MingMingL/little_dog/docs/固件开发环境.md

# 机器狗 V1 固件开发环境说明

> 状态：**首次编译已通过**（2026-10-14），产物 `build/xiaozhi.bin`（2,132,880 字节），板卡 `ai-dog-s3` 已生效；**尚未在真实硬件上验证**（主控仍在途中）。
> 本文所有引脚与命令以 `firmware/xiaozhi-esp32` 工作副本为准。

## 1. 技术选型

语音聊天直接采用开源项目 [xiaozhi-esp32](https://github.com/78/xiaozhi-esp32)（MIT 许可）作为设备端语音栈，不自己实现传输、编解码与打断逻辑。

已确认的关键事实（来自项目 README）：

- 支持 ESP32-S3，通信为 **WebSocket** 或 **MQTT + UDP**，音频为 **Opus**；
- 支持传统 **ASR → LLM → TTS** 级联，也支持 Realtime 端到端语音模型；
- 离线唤醒基于乐鑫 **ESP-SR**，支持自定义唤醒词；具备 AEC 硬件时可全双工；
- 服务端可选官方云 **xiaozhi.me**（本次先用它打通链路），或自建 Python/Java/Go 服务端；
- 构建要求 **ESP-IDF v6.0.1+（推荐 v6.1）**，**不再支持 IDF 5.x**。

## 2. 本机环境

| 项 | 值 |
|---|---|
| IDF 版本 | v6.1 |
| IDF_PATH | `F:\software\EspIdfOnline\.espressif\v6.1\esp-idf` |
| IDF_TOOLS_PATH | `C:\Espressif\tools`（编译器/cmake/ninja/Python 虚拟环境均在此） |
| 环境激活脚本 | `C:\Espressif\tools\Microsoft.v6.1.PowerShell_profile.ps1` |
| Python（IDF） | `C:\Espressif\tools\python\v6.1\venv` |
| Xtensa 工具链 | `xtensa-esp-elf esp-15.2.0_20251204` |

### 两个已踩的坑

1. **不要运行 `install.ps1`**：本机会报 `Start-Process : 已添加项。字典中的关键字:"http_proxy"...`，原因是环境变量里同时存在 `http_proxy` 与 `HTTP_PROXY`（大小写重复键），PowerShell `Start-Process` 会抛异常。工具链本来就已装好，无需再装。
2. **工具链在 `C:\Espressif\tools`，不在 `C:\Users\<你>\.espressif`**。误跑过一次 `idf_tools.py install` 会在 `C:\Users\lmmmm\.espressif` 留下不完整下载（只有 gdb 相关），可安全删除。

## 3. 仓库结构

```
AI-Dog/
├── docs/                       # 文档（PRD 等）
├── firmware/
│   ├── xiaozhi-esp32/          # 工作副本（已 git init，基于上游快照）
│   │   └── main/boards/ai-dog-s3/   # 我们新增的板级配置
│   ├── config/ai-dog-s3.defaults    # 板级选择（Kconfig）
│   └── build-ai-dog.ps1        # 构建/烧录/监视脚本
└── vendor/xiaozhi-esp32/       # 上游只读参考（不要在这改）
```

- `vendor/` 保持上游原样，方便以后 `git pull` 对比升级。
- `firmware/xiaozhi-esp32/` 是真正编译的工程，我们的改动都在这里。

## 4. 板级配置 `ai-dog-s3`

为什么不用现成配置：xiaozhi 对 ESP32-S3 的**默认板级是 `bread-compact-wifi`（面包板精简 WiFi）**，但它假设接了 SSD1306 OLED；我们没有买屏幕，直接编译会在启动时报显示初始化错误。因此新增 `ai-dog-s3`：

- `GetDisplay()` 返回 `NoDisplay()`；
- `GetLed()` 返回 `NoLed`（官方 DevKitC-1 的 GPIO48 是 WS2812，首版先不驱动）；
- 音频引脚沿用官方面包板方案，方便照图接线；
- BOOT 键（GPIO0）：未配网进配网，已配网切换语音对话（对应 PRD **FR-17**）。

### 引脚分配

| 功能 | GPIO | 备注 |
|---|---|---|
| INMP441 WS / SCK / SD | 4 / 5 / 6 | I²S 麦克风输入 |
| MAX98357A DIN / BCLK / LRC | 7 / 15 / 16 | I²S 功放输出 |
| BOOT 按键 | 0 | 配网 / 切换对话 |
| I²C SDA / SCL | 41 / 42 | 给 VL53L0X 测距（屏幕未用） |
| 电池电压采样 | 8 | ADC，需分压后接入 |
| 左电机 PWM / IN1 / IN2 | 11 / 12 / 13 | TB6612，后续阶段启用 |
| 右电机 PWM / IN1 / IN2 | 14 / 21 / 47 | TB6612，后续阶段启用 |
| 电机驱动 STBY | 10 | TB6612 待机控制 |
| 巡线传感器 1–5 | 17 / 18 / 38 / 39 / 40 | TCRT5000 数字输入 |
| 模式切换按键 | 9 | 待机/聊天/巡逻/看门 |

> 已避开 N16R8 的 PSRAM 占用脚（33–37）、Flash 脚（26–32）、USB（19/20）与 strapping 脚（3/45/46）。
> 电机、巡线、看门相关引脚**首版固件尚未初始化**，仅先占位。

## 5. 构建与烧录

```powershell
cd F:\software\workbuddy\AI-Dog\firmware
.\build-ai-dog.ps1                              # 编译
.\build-ai-dog.ps1 -Action flash -Port COM3     # 烧录（按实际串口改）
.\build-ai-dog.ps1 -Action monitor -Port COM3   # 看日志
.\build-ai-dog.ps1 -Action menuconfig           # 改配置
```

脚本里已固化下面 5 项环境修正（**别删**，删了就会复现首次编译时那串报错）：

1. `IDF_COMPONENT_CACHE_PATH` → 工作区：组件管理器默认往 `%LOCALAPPDATA%\Espressif\ComponentManager\Cache` 解压，会被拒写。变量名必须是 `IDF_COMPONENT_CACHE_PATH`（前缀 + `CACHE_PATH` 字段），写成 `IDF_COMPONENT_CACHE` 会静默失效。
2. `CODEBUDDY_SAFE_DELETE_ENABLED=0`：cmake 配置阶段会批量删临时文件，超过 50 个文件即被保护机制 fail-closed 拦截，configure 直接失败。
3. `TMP/TEMP` → `firmware/.build-tmp`：`gcc`/`as` 的临时文件默认在系统 Temp，编译到一半会被拒。
4. `CCACHE_DISABLE=1`：ccache 的临时目录同样会被拒；首次编译本来也用不上缓存。
5. 重配置时加 `-DCMAKE_NINJA_FORCE_RESPONSE_FILE=1`：链接 `xiaozhi.elf` 前的编译命令有上百个 `-I`，会撞 Windows 命令行 32767 字符上限报 `CreateProcess: The parameter is incorrect`。CMake 打印的 "变量未被使用" 是误报，`build.ninja` 里确实生成了 `RSP_FILE`。

其它经验：构建需在**非沙箱模式**下跑（沙箱会在编译到第 1000 个目标左右开始拒绝 .obj 写入）；失败后续跑 `ninja -C build all` 是增量的，不要删 `build/` 重来；`.ps1` 脚本保持 ASCII（PowerShell 5.1 按 GBK 读无 BOM 文件，中文注释会破坏解析）。

### 首次编译产物

| 文件 | 大小 | 说明 |
|---|---|---|
| `build/xiaozhi.bin` | 2,132,880 B（约 2.0 MB） | 主程序，16 MB flash 余量充足 |
| `build/bootloader/bootloader.bin` | 16,736 B | 二级 bootloader |
| `build/partition_table/partition-table.bin` | 3,072 B | 分区表 |
| `build/ota_data_initial.bin` | 8,192 B | OTA 初始数据 |

`sdkconfig` 中已生效：`CONFIG_BOARD_TYPE_AI_DOG_S3=y`、`CONFIG_IDF_TARGET="esp32s3"`。

烧录完成后，按官方流程配网（热点或 BluFi），设备默认连接 xiaozhi.me；登录控制台即可配置大模型与音色。

## 6. 与 PRD 的对应

| PRD 条目 | 现状 |
|---|---|
| FR-17 聊天发起（按键） | 已由 BOOT 键实现（照 xiaozhi 默认行为） |
| FR-18 云端语音链路 | 由 xiaozhi + xiaozhi.me 提供，凭据在服务端 |
| FR-19 半双工回声控制 | 首版沿用 xiaozhi 行为；全双工/AEC 待真机验证后再评估 |
| FR-20 失败处理 | xiaozhi 已有重连/超时处理，需真机验证 |
| FR-21 唤醒词 | 后续可选（ESP-SR），先按键 |
| §8 软件架构 | PRD 原写「ESP-IDF/Arduino-ESP32」，实际采用 ESP-IDF v6.1 + xiaozhi 语音栈，已在 PRD 中同步 |

## 7. 后续接入点（硬件到货后）

1. 在 `ai_dog_s3_board.cc` 里加模式状态机（待机/聊天/巡逻/看门）与互锁（FR-01、FR-09）。
2. 接巡线与 VL53L0X，实现循线行驶与遇障停车（FR-06、FR-07、FR-08）。
3. 用同一路麦克风做看门声检测（能量阈值 + 持续时间 + 冷却），触发本地狗叫（FR-11～FR-14）。
4. 通过 MCP 把「开始巡逻 / 设防」等动作暴露给语音，实现用说话控制机器狗。
5. 再评估是否从 FR-19 的半双工升级到全双工（取决于 AEC 实测效果）。
