MingMingL/little_dog/output/机器狗V1产品需求文档.md

# 机器狗 V1 产品需求文档（PRD）

| 项目 | 内容 |
|---|---|
| 文档版本 | 0.1（评审草案） |
| 日期 | 2026-10-13 |
| 产品形态 | 2WD 轮式移动机器人，外观采用 3D 打印狗形外壳 |
| 目标读者 | 产品、嵌入式/硬件、Android、测试 |
| 当前状态 | 需求范围已初步收敛；硬件型号、云服务与若干阈值待验证 |
| 交付形式 | Markdown |
| 预算口径 | 硬件目标约 ¥500（估算，非报价）；云服务费与已有设备不计入 |

## 修订记录

| 版本 | 日期 | 修订说明 | 修订人 |
|---|---|---|---|
| 0.1 | 2026-10-13 | 首版草稿：确定 2WD 固定路线方案、功能需求、验收标准与预算表 | 待填写 |

## 评审摘要（30 秒结论）

- **做什么：** 2WD 轮式狗形原型，提供固定路线循线巡逻（遇障停车）、本地声音触发狗叫告警、云端语音聊天三类能力。
- **不做什么：** 不做 SLAM/自由地图导航、四足步行、自动回充，也不做门外声源定位或认证级安防。
- **硬件目标：** 约 ¥500，估算值；预算表合计约 ¥492，仅约 ¥8 机动空间。
- **最大风险：** 电机堵转电流、驱动板连续电流、2S 电池化学体系/BMS/充电器尚未核实 —— 这三项定稿前不建议下单。
- **必须澄清的边界：** 单麦克风只能判断声音强度，不等于「声音来自门外」；本原型不替代门磁或经认证的安防产品。

## 术语与缩写

| 术语 | 含义 |
|---|---|
| 2WD | 两轮驱动差速底盘，本方案的轮式底盘形态 |
| SLAM | 同步定位与建图；本版不做 |
| ToF | 飞行时间测距，用于前向障碍检测 |
| BMS | 电池管理系统/保护板，负责过充、过放、过流保护 |
| ADC | 模数转换器，用于把分压后的电池电压读入主控 |
| I²S / I²C / GPIO / PWM | 音频总线 / 传感器总线 / 通用引脚 / 脉宽调制（电机调速） |
| ASR / LLM / TTS | 语音识别 / 对话大模型 / 语音合成 |
| P0 / P1 | 首版必须具备 / 首版可选或紧随其后的增强项 |

## 目录

1. 产品概述
2. 用户问题与目标
3. 用户与使用场景
4. 产品范围与模式
5. 功能需求（含 P0 交付清单）
6. 关键交互流程
7. 硬件与系统约束
8. 软件架构建议
9. 非功能需求
10. 验收标准（V1）
11. 预算目标（硬件）
12. 里程碑建议
13. 风险登记表
14. 开放问题与待决策项
15. 参考资料与边界说明

---

## 1. 产品概述

本项目拟制作一台面向家庭室内场景的低成本轮式机器狗原型，提供语音聊天、沿预设路线巡逻，以及在门口听到明显声音后播放狗叫警报三类能力。首版以 ESP32-S3 为设备主控，使用家庭 Wi‑Fi 连接云端语音服务；声音检测、模式判断、运动控制和报警播放尽可能留在本机，使看门报警不因外网中断而失效。

**V1 的自动巡逻定义为“循地面标线沿固定路线行走，检测到障碍后停车”**，不包含室内建图、定位到任意目标点、SLAM 或自主绕行。机器狗在看门模式下应停留在靠近入口的位置；单麦克风只能判断声音强度/特征，不能可靠证明声音来自门外，也不承诺识别或区分门铃、敲门、脚步和室内噪声。

硬件预算目标约 ¥500，作为原型采购控制线，不是已锁定的供应商报价。云端 ASR/LLM/TTS 使用费、服务端费用以及已有电脑、手机不计入该硬件预算。

## 2. 用户问题与目标

### 2.1 用户问题

- 希望以较低成本获得一台能移动、能说话且有“狗”外观的家庭机器人原型。
- 希望机器能按简单固定路线巡逻，并在撞上家具前停下。
- 希望离家或夜间时有声音提醒，但无需购买摄像头或完整智能安防系统。
- 希望可以与设备进行自然语言语音对话，而不要求设备端运行大型语音/语言模型。

### 2.2 V1 产品目标

1. 用户可通过设备按键或 Android 控制端切换聊天、巡逻、看门模式。
2. 巡逻模式下沿预先铺设的地面标线行走；检测到前方障碍后停止并提示。
3. 看门模式下在本地检测明显声音并播放预置狗叫音频；无网络时该流程仍可工作。
4. 聊天模式下通过 Wi‑Fi 使用云端语音识别、对话模型和语音合成，并从机器狗扬声器播放回复。
5. 在包含开发板、电源、基础调试材料和 3D 打印外壳的前提下，硬件采购尽量不超过 ¥500。

### 2.3 本期范围（做 / 不做）

| 分类 | 内容 |
|---|---|
| **本期做（P0）** | 2WD 轮式底盘 + 3D 打印狗形外壳原型 |
| | 循地面标线的固定路线巡逻，遇障停车 |
| | 本地声音检测触发狗叫告警（断网仍可用） |
| | 云端 ASR → LLM → TTS 语音聊天，按键/App 发起，半双工 |
| | 四种互斥模式（待机/聊天/巡逻/看门）与本地状态反馈 |
| **本期不做（留待后续）** | 四足步行、爬楼梯、跨越门槛、户外行驶 |
| | 激光雷达建图、自由路径规划、房间级定位、自动回充 |
| | 摄像头直播、人脸识别、门外声源定位、可靠的入侵者识别 |
| | 认证级安防能力：不替代门磁、烟雾报警器或经认证的安防产品 |
| | 完全离线的开放域语音聊天，以及云端语音服务的长期免费保证 |

## 3. 用户与使用场景

### 3.1 用户

- **家庭用户/项目所有者：** 设置看门时段、启停巡逻、与机器狗聊天并进行日常维护。
- **开发与调试者：** 通过串口日志、状态页和手动控制检查传感器、电机与电源。

### 3.2 核心场景

| 场景 | 前置条件 | 期望结果 |
|---|---|---|
| 夜间看门 | 机器狗放置在玄关附近，已设防 | 检测到达到阈值的声音后，在本地播放狗叫；不依赖外网 |
| 离家看门 | 用户在 App 手动设防；V1 可另设计划时段 | 持续监听并在触发后本地报警；用户可在回家后撤防 |
| 固定路线巡逻 | 已铺设并标定地面路线，路径无大台阶 | 机器狗循线移动，前方有障碍时停车 |
| 语音聊天 | Wi‑Fi 和已配置的云端语音服务可用 | 用户发起一轮语音输入，设备播放云端生成的语音回复 |
| 网络中断 | 已进入看门模式 | 本地看门与狗叫可用；聊天显示/播报网络不可用，不导致设备崩溃 |
| 电量不足 | 电池接近低压保护阈值 | 停止移动，播放或显示低电量提示；禁止继续反复启动电机 |

## 4. 产品范围与模式

V1 采用互斥模式，避免巡逻移动时把移动噪声误当成入口声音，也避免聊天播报触发声音报警。

| 模式 | 设备行为 | 网络依赖 | 退出方式 |
|---|---|---|---|
| 待机 | 电机关闭，传感器维持必要状态 | 无 | App/按键切换模式 |
| 聊天 | 半双工收音与语音播放；V1 默认按键发起，不要求常开唤醒 | 需要 Wi‑Fi 和云语音服务 | 用户结束、超时或切换模式 |
| 巡逻 | 低速循线；测距达到停车阈值即停止 | 本地运行；App 控制建议同一局域网 | 用户停止、路线丢失、障碍/故障、电量不足 |
| 看门 | 底盘停止；麦克风进行本地声音判定；满足条件后播放狗叫 | 报警不依赖网络；计划表需本地保存 | 用户撤防、切换模式或低电量故障 |

V1 看门设防方式为**App 手动设防/撤防 + 可选本地时间计划**。离家地理围栏自动设防属于后续需求，需额外评估 Android 后台定位权限、耗电和用户授权，不作为当前硬性承诺。

## 5. 功能需求

优先级定义：P0 为首版必须具备，P1 为首版可选或紧随其后的增强项。

### 5.0 P0 交付清单（首版范围冻结依据）

| 模块 | P0（首版必须具备） | P1（可选/后续） |
|---|---|---|
| 模式管理与控制 | FR-01、FR-02、FR-03 | FR-04、FR-05 |
| 固定路线巡逻与避障 | FR-06、FR-07、FR-08、FR-09 | FR-10 |
| 看门声音检测与报警 | FR-11、FR-12、FR-13、FR-14 | FR-15、FR-16 |
| 语音聊天 | FR-17、FR-18、FR-19、FR-20 | FR-21 |
| **合计** | **15 条** | **6 条** |

### 5.1 模式管理与控制

- **FR-01（P0）：模式切换。** 提供待机、聊天、巡逻、看门四种状态；任一时刻仅允许一个主要模式运行。切换前停止电机和当前音频任务，再启用新模式。
- **FR-02（P0）：急停。** 设备提供可触达的物理电源/电机停止手段；App 提供停止命令。远程手动驾驶时控制心跳中断、控制任务异常或模式切换时，电机默认进入停止状态；本地自治巡逻不依赖外网，遇到传感器/控制故障仍须停车。
- **FR-03（P0）：本地状态反馈。** 至少通过 App 页面或串口日志显示当前模式、Wi‑Fi 状态、电量估计/低电压状态、最近错误和看门报警次数。
- **FR-04（P1）：按时设防。** 支持配置每日开始与结束时间，计划保存在设备端；重启后恢复计划。时间未同步时不应悄悄进入错误设防状态。
- **FR-05（P1）：离家自动设防。** 后续可评估手机地理围栏；必须由用户显式授权并能手动撤销，不能仅依据网络断开判定用户离家。

### 5.2 固定路线巡逻与避障

- **FR-06（P0）：循线行驶。** 使用底部多路红外巡线传感器识别地面黑/白标线，执行左右轮差速控制。路线需由用户提前铺设；V1 不提供地图编辑器。
- **FR-07（P0）：障碍停车。** 使用前向 ToF 或等效测距传感器；距离低于可配置阈值时停止两侧电机并进入“受阻”状态。V1 优先安全停车，不要求绕过障碍。
- **FR-08（P0）：路线丢失保护。** 连续一段时间无法识别路线时停车并提示，不允许在不确定方向下持续行驶。
- **FR-09（P0）：限速与看门互锁。** 巡逻速度可配置但受固件上限约束；看门模式必须关闭电机，聊天播报期间暂停/抑制声音触发，减少自触发。
- **FR-10（P1）：巡逻状态提示。** 显示开始、运行、受阻、路线丢失、停止等状态；保存本次巡逻的开始/结束时间和停止原因。

### 5.3 看门声音检测与报警

- **FR-11（P0）：本地声音检测。** 在看门模式下从数字麦克风采样，估算短时声音能量；仅在阈值、持续时间和冷却条件同时满足时触发报警。
- **FR-12（P0）：本地狗叫。** 触发时从本地存储播放预置狗叫音频；报警播放不得依赖云端服务或联网。
- **FR-13（P0）：误报抑制。** 提供环境噪声基线/灵敏度档位、最短事件持续时间和报警冷却时间；狗叫播放期间屏蔽麦克风事件判定，播放结束后经过恢复间隔再监听。
- **FR-14（P0）：设防可见。** 设备或 App 明确显示“看门已设防/已撤防”；启动看门模式前提示设备需靠近入口放置，并说明声音检测不等于门外声源识别。
- **FR-15（P1）：事件记录。** 本地保留最近 N 条报警时间与触发强度摘要；V1 默认不保存原始音频，不上传连续环境录音。
- **FR-16（P1）：手机推送。** 仅在后续服务端与网络方案确定后实现；即使推送失败，本地狗叫也必须已执行。

### 5.4 语音聊天

- **FR-17（P0）：聊天发起。** V1 通过按键或 App 按住说话/点按录音开始，提供清楚的录音中、处理中、播放中和失败状态；不要求设备始终监听唤醒词。
- **FR-18（P0）：云端语音链路。** 服务端采用 ASR → LLM → TTS 级联流程；设备通过 Wi‑Fi 传输音频或压缩语音片段，并播放返回语音。各服务商应可配置替换，凭据仅存放服务端。
- **FR-19（P0）：半双工回声控制。** 播放 TTS 时暂停采音或不提交新输入；用户开始下一轮后恢复采音。首版不承诺免提全双工、低延迟插话或远场识别。
- **FR-20（P0）：失败处理。** Wi‑Fi、ASR、LLM 或 TTS 请求失败时，显示/播报简短失败提示、允许重试，并保持底盘处于安全停止状态；单次请求失败不得使主控重启。
- **FR-21（P1）：唤醒词。** 可评估 ESP-SR WakeNet 唤醒；唤醒词、麦克风位置、误唤醒率和内存占用通过原型验证后再纳入。

## 6. 关键交互流程

### 6.1 看门设防

1. 用户将机器狗放在玄关附近，确认其不会挡住通道或被门碰撞。
2. App/按键选择“看门”，选择立即设防或已保存的时间计划。
3. 设备确认底盘已停止、低电压未触发、麦克风与扬声器初始化成功。
4. 状态变为“看门已设防”；达到声音条件时本地播放狗叫，并按冷却规则记录一次事件。
5. 用户在 App 或设备端撤防；设备停止报警任务并恢复待机。

### 6.2 巡逻

1. 用户预先铺好闭合或端点明确的地面路线，并清除楼梯、易缠绕电缆等风险。
2. 用户启动巡逻；设备确认传感器可读、电池状态正常后低速启动。
3. 设备循线行驶；遇障立即停车并进入受阻状态。
4. 用户移除障碍并通过 App/按键恢复，或直接终止巡逻。
5. 路线丢失或传感器故障时设备停车并报告原因。

### 6.3 语音聊天

1. 用户按键/App 发起语音输入；设备提示正在录音。
2. 用户结束输入；设备上传到已配置的服务端。
3. 服务端返回语音后设备播放；播放期间暂停采音，避免扬声器回声。
4. 用户可开始下一轮、结束会话或切换模式。
5. 任一网络/服务环节失败时给出可重试错误提示，不影响看门本地逻辑或电机安全状态。

## 7. 硬件与系统约束

### 7.1 V1 候选硬件

| 子系统 | 候选规格/器件 | 需求与备注 |
|---|---|---|
| 主控 | ESP32-S3 N16R8 开发板 | Wi‑Fi、I²S 音频、GPIO 与电机 PWM；作为语音设备主控 |
| 底盘 | 2WD 双轮差速，含两台减速电机、车轮、支撑轮 | 以室内平地为主；编码器可选，首版循线不依赖高精度里程计 |
| 电机驱动 | TB6612FNG 类双 H 桥，或与电机堵转电流匹配的等效板 | 区分电机电源 VM 与逻辑 VCC；不能只看峰值参数，应核对每通道连续电流、散热和电机堵转电流 |
| 路线传感 | 5 路 TCRT5000 类巡线传感器 | 输出必须兼容 ESP32-S3 3.3V GPIO；如输出为 5V，需电平转换/分压方案 |
| 障碍传感 | VL53L0X 类前向 ToF 测距模块 | I²C 接口；按模块电气规格供电和接线 |
| 音频输入 | INMP441 类 I²S 数字麦克风 | 3.3V 逻辑/供电按模块规格确认；布置在机器狗头部或前上方 |
| 音频输出 | MAX98357A 类 I²S 功放 + 4Ω/3W 小喇叭 | 功放电源与扬声器阻抗按模块规格核对；音频播放时抑制麦克风自触发 |
| 电池 | 候选 2S 7.4V、2000mAh、40C 电池组 | “7.4V”为标称电压，满电约 8.4V；确认化学体系、电芯可信度、BMS/保护方式、放电能力和接口后再采购 |
| 电源转换 | 电机支路按电机额定电压选降压；逻辑与音频支路提供稳定电源；按实际电压拓扑配置各路稳压 | 先空载调压并用万用表确认，再接负载；电机电源不能接到逻辑 VCC |
| 电池电压采样 | 高阻分压接 ESP32-S3 ADC，或使用兼容电池化学体系的电压监测模块 | 若要提供低电压提示/停机，此项必需；分压电阻用直插件即可，阻值需按 ADC 最大输入电压计算 |
| 外壳 | FreeCAD 等自行建模，PLA 代打 | 打印非承重上盖、头部、传感器支架；优先复用金属/塑料底盘，预留通风、维修和电池拆装空间 |
| 调试/装配 | 400 孔面包板、杜邦线、洞洞板、用户按键、总开关、保险丝、线束及电池电压采样电阻 | 面包板仅桌面调试；车载连接改为焊接洞洞板/可靠插接；电机电流不得通过面包板；电池采样电阻不要求贴片封装 |
| 控制端（可选） | 已有的 Android 手机 | 运行 App 与控制界面；不计入硬件预算，见 Q-06 |

### 7.2 电气安全约束

- 电池、驱动板、电机和降压模块须按实际电压/电流规格匹配；2S 电池满电电压为 8.4V。
- TB6612FNG 的逻辑输入电源 VCC（常见 3.3–5V）与电机电源 VM 是不同接口；严禁把 2S 电池直接接到逻辑 VCC。东芝列出的 TB6612FNG 芯片输出规格约为每通道平均 1.2A、峰值 3.2A；峰值不能当作持续电流能力，模块板散热也会影响实际值。若商品页标注“2A/3.2A”，须核实该数字是连续/短时、单通道/整板。
- 最终电机驱动器按“两台电机各自的堵转电流和两侧同时启动”核算；若选用 4WD 或每侧电机并联，需重新评估驱动板、电池、线束和保险丝，当前 V1 不覆盖。
- 电池正极附近设置保险丝和实体总开关；软件通过电压采样实现低电压提示/停机，阈值须按最终电芯化学体系及每串电压要求确定。充电器必须与电池化学体系、串数、充电接口/平衡接口匹配。
- 若使用带 BMS 的 2S 成品电池组，BMS 持续放电电流可先以 ≥5A 作为筛选下限，最终须按两台电机的堵转/启动电流总和、主控与音频负载并留余量复核。若候选 40C 航模电池没有 BMS，则不存在可核对的“BMS 持续电流”参数，应核实电芯放电规格，并使用合适的低压保护和匹配的平衡充电器。
- 40C 是候选电池标称参数，不作为系统电流保证；若为无 BMS 航模 LiPo，须使用匹配的 2S 平衡充电器和低压保护，充电过程按电池供应商安全要求执行。
- 51 单片机套件可以作为底盘/电机驱动的候选来源，但不默认作为语音聊天主控。若购买套件，先确认是否已经包含驱动器、电机和电池盒，避免重复采购；ESP32-S3 与 51 板的职责需明确。若保留 51 板，ESP32-S3 是唯一电机命令源，不能让两块主控同时控制同一驱动输入；逻辑电平须确认兼容 3.3V GPIO。

## 8. 软件架构（已确定）

**基座选型：** 固件以开源项目 [xiaozhi-esp32](https://github.com/78/xiaozhi-esp32)（MIT 许可证）为语音聊天基座，基于 **ESP-IDF v6.1**（不支持 5.x）构建；已注册自定义板卡 `ai-dog-s3`（ESP32-S3-N16R8 + INMP441 + MAX98357A，无屏幕），语音云端首选 xiaozhi.me 官方服务。

| 层 | 职责 | 实现接口/技术 |
|---|---|---|
| 语音聊天（已就绪） | 唤醒、音频编解码、ASR→LLM→TTS 流水线、云端会话 | xiaozhi-esp32；Opus + WebSocket/MQTT+UDP；离线唤醒词走 ESP-SR |
| 设备状态机 | 模式互斥（聊天/巡逻/看门）、错误恢复、低电量保护、看门计划 | ESP-IDF v6.1 自研任务；状态转换显式定义 |
| 运动控制 | TB6612FNG PWM、巡线传感、测距停车、软急停 | 电机驱动 GPIO/LEDC PWM；传感器 I²C/GPIO |
| 音频扩展 | 看门人模式声音触发狗叫（本地、断网可用） | INMP441 本地采样 + SPL 阈值检测；报警音本地存储/合成 |
| 网络控制 | 配网、设备状态、语音云端请求、MCP 设备控制 | xiaozhi 既有 WebSocket 通道；MCP 工具暴露电机/模式命令 |
| 语音服务端 | ASR、LLM、TTS 级联 | xiaozhi.me 云端；可迁移自建（xinnan-tech Python 版 / joey-zhou Java 版） |
| Android 控制端 | 模式设置、手动设防、巡逻启停、状态和事件查看 | Java Android App；V1 可先做最小控制界面 |

固件须采用"控制任务优先于聊天任务"的资源调度原则。语音网络请求和音频播放不能阻塞电机安全任务；网络/云服务故障时可独立保持本地状态机运行（看门检测与狗叫为纯本地逻辑，不依赖云端）。

## 9. 非功能需求

- **安全优先：** 电机控制异常、线路丢失、障碍、低电压、看门模式切换时默认停车。
- **断网韧性：** 看门检测及本地狗叫在 Wi‑Fi/云端不可用时仍有效；聊天在断网时明确失败并可重试。
- **可恢复性：** 单次传感器读取失败、云端请求超时或播放错误不能使系统崩溃；记录错误并进入安全状态。
- **可维护性：** 电机、音频、传感器、云服务配置分层，模块可单独替换；固件日志包含时间、模式、错误码，不输出密钥。
- **隐私：** 默认不保存或上传连续环境录音；语音聊天只上传用户主动发起的一轮；设置页说明云端处理范围和服务依赖。
- **可用性：** 设防状态、设备状态和故障原因对用户可见；用户能从 App 或实体开关快速停机。
- **供电：** 目标续航需经整机样机实测后确定，首轮验证目标为混合使用至少 30 分钟；续航数值不是未测试前的保证。
- **语音延迟基线：** 首版不设硬性端到端延迟门槛，但需按环节（VAD/ASR/LLM/TTS/播放）记录耗时中位数作为基线；后续优化目标为端到端 ≤800ms。首版以按键半双工实现，不追求全双工插话。
- **成本可控：** 采购前须按实际 SKU、运费和必需辅料复核总额；超 ¥500 须明确删项或重新审批（见 AT-10）。

## 10. 验收标准（V1）

| 编号 | 验收项 | 通过标准 |
|---|---|---|
| AT-01 | 模式与急停 | 四种模式互斥；按下物理停止后电机停止；远程手动驾驶时控制心跳丢失后 1 秒内停车；巡逻模式在外网断开时仍由本地状态机运行，遇传感器/控制故障停车 |
| AT-02 | 循线 | 在平整硬地面铺设约 5m 闭合路线，使用约 15–20mm 黑色胶带（最终以传感器实测标定）；连续运行 10 次，至少 9 次完成路线；中途丢线必须停车并报告 |
| AT-03 | 避障 | 在前向测距有效范围内放置哑光、非透明障碍物，固定停车阈值后重复 10 次；至少 9 次在接触前停车，故障时不继续驱动 |
| AT-04 | 看门触发 | 设备固定在入口附近，调整灵敏度后，对定义的敲击/门铃测试声 10 次至少触发 9 次；连续安静环境 30 分钟误报不超过 1 次。该指标只针对实验条件，不等于真实安防识别率 |
| AT-05 | 本地报警 | 断开互联网但保持设备供电，触发声音后仍能播放狗叫；播放音频不会连续自触发形成报警循环 |
| AT-06 | 设防/撤防 | 用户可立即设防和撤防；若实现计划设防，设备重启后计划仍存在，撤防后不触发报警 |
| AT-07 | 语音聊天 | 在 Wi‑Fi 和服务端可用情况下完成至少 20 轮问答，成功播放率不低于 19/20；播放回复时不会把回复识别成新的用户输入 |
| AT-08 | 网络故障 | 在聊天过程中断网，设备显示/播报失败并允许重试；设备不重启；巡逻状态机、避障和看门报警可离线运行，App 远程控制暂不可用时依旧保持安全状态 |
| AT-09 | 低电压与电源 | 模拟低电压后停止电机并提示；不同电源支路电压在各自额定范围内，无意外复位或明显过热 |
| AT-10 | 预算与采购 | 核对实际 SKU、运费和必需辅料后硬件合计不超过 ¥500；超预算须明确删项或重新审批，不得遗漏必需电源/保护/外壳费用 |

## 11. 预算目标（硬件）

| 类目 | 数量 | 预算目标 | 必需性 | 说明 |
|---|---:|---:|---|---|
| ESP32-S3 N16R8 主控 | 1 | ¥75 | 必需 | 语音与运动主控 |
| 2WD 底盘与两台电机 | 1 套 | ¥75 | 必需 | 编码器可选，首版循线不强依赖 |
| 双路电机驱动板 | 1 | ¥12 | 必需 | 须按电机堵转电流选型 |
| 巡线传感器 + 前向测距模块 | 1 套 | ¥25 | 必需 | 巡逻与避障感知 |
| 麦克风 + I²S 功放 + 小喇叭 | 1 套 | ¥30 | 必需 | 语音输入、播报、狗叫 |
| 2S 电池组 + 匹配充电器 | 1 套 | ¥95 | 必需 | 化学体系与接口须先确认 |
| 两路降压与电源转换 | 2 | ¥20 | 必需 | 先空载调压再接负载 |
| 面包板 + 杜邦线 | 1 套 | ¥10 | 调试用 | 车载运行须改为焊接/插接 |
| 洞洞板、线材、端子、螺丝、开关、保险丝 | 若干 | ¥40 | 必需 | 含电池电压采样分压电阻 |
| PLA 外壳/支架打印 | 1 套 | ¥60 | 可延后 | 建议裸底盘跑通后再打 |
| 万用表 | 1 | ¥20 | 已有可省 | 调压与查电压必需 |
| 运费与价格浮动预留 | — | ¥30 | 必需 | 控制总预算 |
| **预算合计** | | **约 ¥492** | | 目标上限 ¥500 |

预算为初步分配；该表合计留有约 ¥8 空间，任何高于目标价的商品都可能导致超支。万用表若已有可移除；淘宝套件如包含驱动板、电池盒或传感器，应先核对并扣除重复项。传感器板和驱动模块通常已有自身外围电路，不需为它们额外购买贴片电阻；但若按本 PRD 用 ESP32 ADC 监测电池电压，则需要一组按电压范围选值的分压电阻（直插件即可），费用由装配辅料预算承担。若改用带电压输出的监测模块则可省去该分压。云服务费、手机、开发电脑不含在表内。

## 12. 里程碑建议

1. **M0 物料确认：** 锁定底盘电机电压/堵转电流、驱动板连续电流、电池化学体系与充电方式；完成电源图和接口表。
2. **M1 供电与底盘：** 先验证降压、急停、单电机与双电机控制，完成限速、断联停车和低电压策略。
3. **M2 巡线避障：** 完成传感器标定、固定路线循线、障碍停车与丢线恢复；通过 AT-02、AT-03。
4. **M3 本地看门：** 完成声音能量判定、冷却、狗叫播放、设防/撤防和离线验证；通过 AT-04 至 AT-06。
5. **M4 云端聊天与 App：** 完成按键说话、服务端级联、TTS 播放、断网/超时处理和基本状态控制；通过 AT-07、AT-08。
6. **M5 结构与整机验收：** 根据真实器件尺寸完成狗形外壳，整理线束、验证温升和续航，完成全部验收与成本复核。

## 13. 风险登记表

| 编号 | 风险 | 等级 | 影响 | 应对原则 |
|---|---|---|---|---|
| R-01 | 2WD 商品实际电机额定电压、堵转电流未知 | 高 | 可能损坏驱动器或导致启动复位 | 采购前索取具体电机数据；不能仅凭“2A/3.2A 峰值”认定可长期驱动 |
| R-02 | 2S 2000mAh/40C 电池化学体系、BMS 和接口未核实 | 高 | 充电/欠压/短路安全风险 | 确认 LiPo/Li-ion、BMS/平衡口、输出口和配套充电器；加保险丝与欠压保护 |
| R-03 | 51 单片机 2WD 套件与 ESP32-S3 方案部件重叠 | 中 | 重复花费、主控接口不一致 | 采购前确认套件清单；若使用 51 板仅复用可兼容的底盘/驱动器，语音主控仍由 ESP32-S3 负责 |
| R-04 | 单麦克风把室内声音当成入口声 | 中 | 看门误报或漏报 | 机器人靠近入口固定放置，增加基线/持续时间/冷却；产品明示非声源定位与非认证安防 |
| R-05 | 2WD 小轮越不过门槛或地毯阻力大 | 中 | 巡逻失败、堵转发热 | V1 限于平整硬质地面；门槛/地毯环境需重新评估 4WD 或底盘，不以改软件掩盖机械限制 |
| R-06 | 云端语音成本、延迟与可用性变化 | 中 | 聊天体验波动 | ASR/LLM/TTS 服务供应商可替换；先按键半双工验证；成本另计并设置请求超时/重试边界 |
| R-07 | 外壳增重和遮挡传感器 | 低 | 行驶性能、声音拾取或测距受损 | 先用裸底盘验证，再按实物量尺寸建模；传感器开孔和散热需进入结构评审 |

## 14. 开放问题与待决策项

| 编号 | 待决策问题 | 影响 | 建议决策时点 | 责任方 |
|---|---|---|---|---|
| Q-01 | 具体 2WD 底盘商品，以及是否自带驱动板 | 决定采购清单与是否重复购买 | M0 下单前 | 待填写 |
| Q-02 | 电机额定电压/堵转电流，驱动板型号与连续电流 | 决定驱动与供电是否安全 | M0 下单前 | 待填写 |
| Q-03 | 2S 电池化学体系、保护/充电方式与插头规格 | 决定充电器与安全策略 | M0 下单前 | 待填写 |
| Q-04 | 手机控制端走局域网还是远程 | 决定 App 架构与是否需要服务端中转 | M4 开发前 | 待填写 |
| Q-05 | 看门时间计划是否纳入 V1 | 影响 FR-04、AT-06 是否验收 | 需求评审时 | 待填写 |
| Q-06 | 是否复用旧 Android 手机作为 App 载体 | 不影响预算，影响调试便利性 | 可随时 | 待填写 |

## 15. 参考资料与边界说明

- 乐鑫 ESP32-S3 技术规格（[官方文档](https://documentation.espressif.com/esp32-s3_datasheet_cn.html)）
- 乐鑫 ESP-SR：AFE、WakeNet、MultiNet 等语音能力（[官方入门指南](https://docs.espressif.com/projects/esp-sr/zh_CN/latest/esp32s3/getting_started/readme.html)）
- 东芝 TB6612FNG 产品页（[官方页面](https://toshiba-semicon-storage.com/cn/semiconductor/product/motor-driver-ics/brushed-dc-motor-driver-ics/detail.TB6612FNG.html)）

上述资料用于说明候选平台与器件能力边界，不代表已选定商品或保证具体淘宝 SKU 参数。所有硬件电气参数以最终采购商品的数据表和实测为准。
