MingMingL/little_dog/docs/source/breadboard-z-outline-preview.png

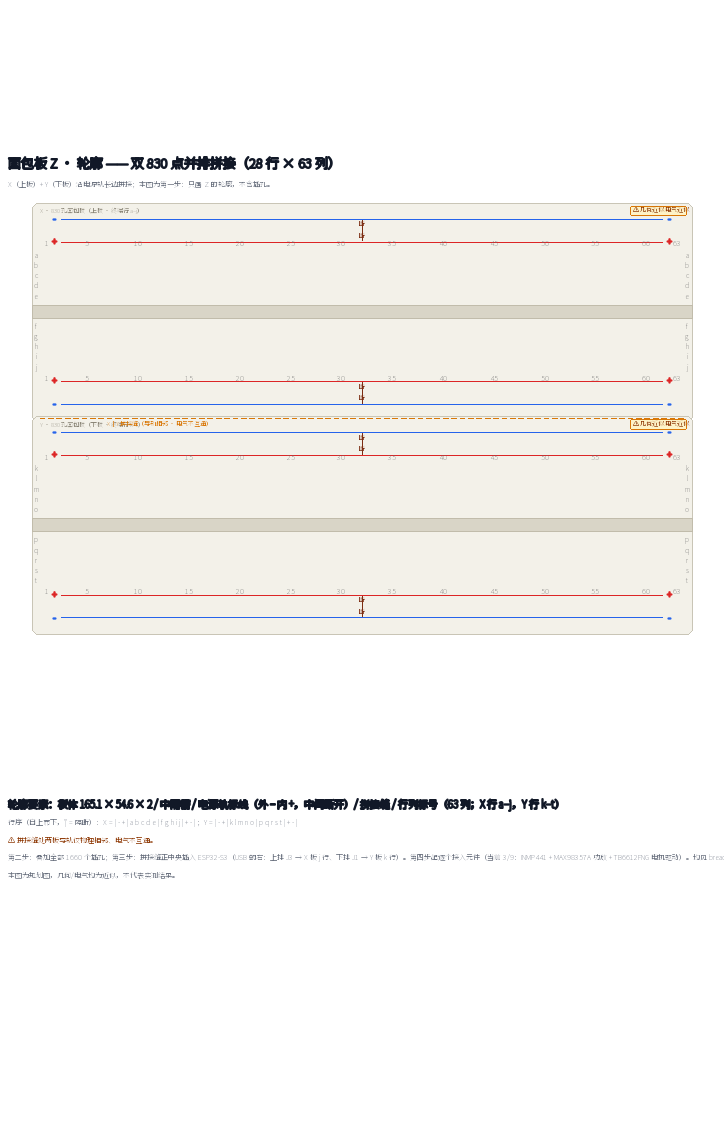
docs/source/breadboard-z-outline-preview.png
