MingMingL/little_dog/docs/source/breadboard-z-preview.png

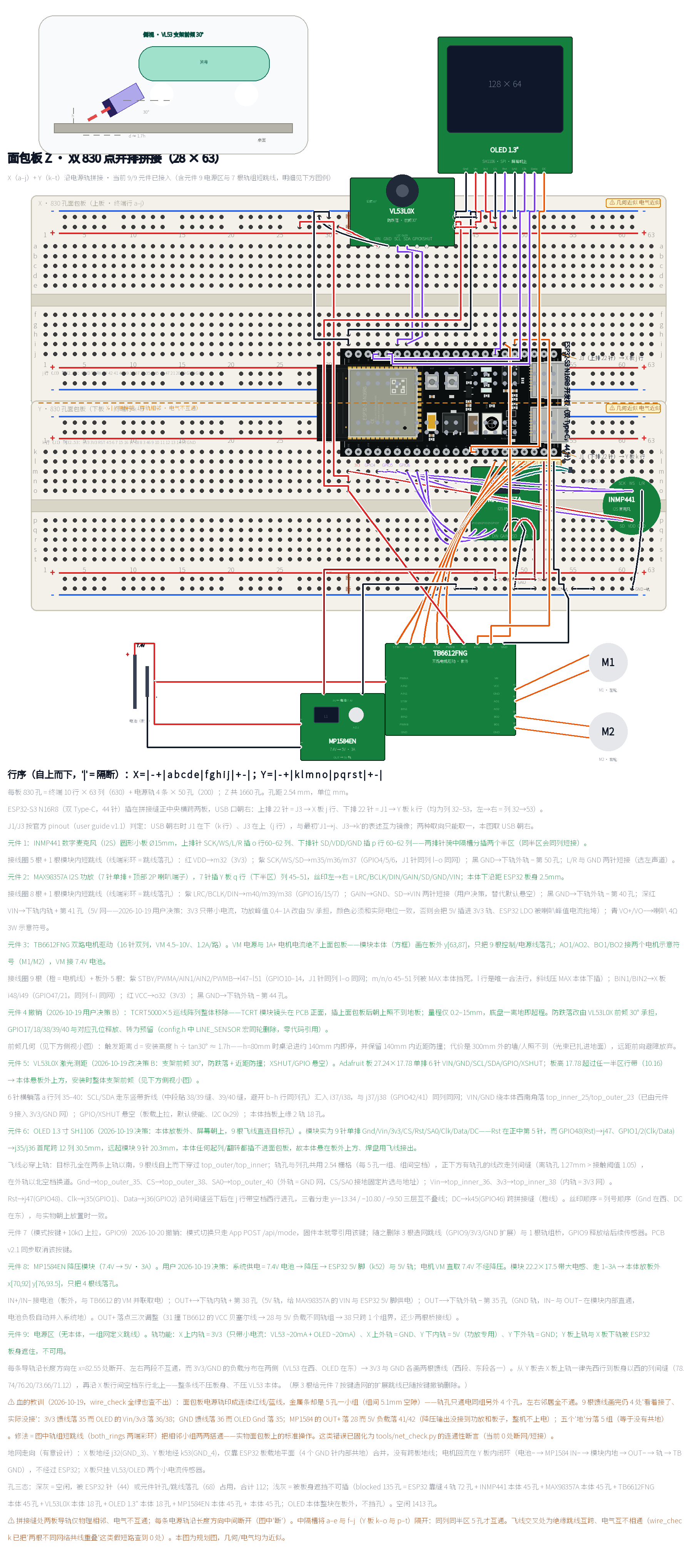
docs/source/breadboard-z-preview.png
