MingMingL/little_dog/docs/source/breadboard-z.png

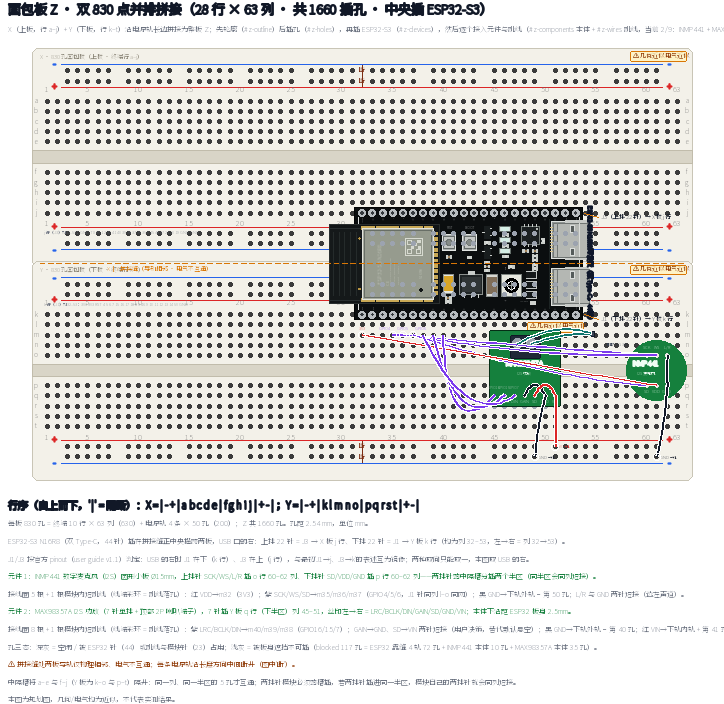
docs/source/breadboard-z.png
