MingMingL/little_dog/docs/source/pcb-layout-v1-preview.png

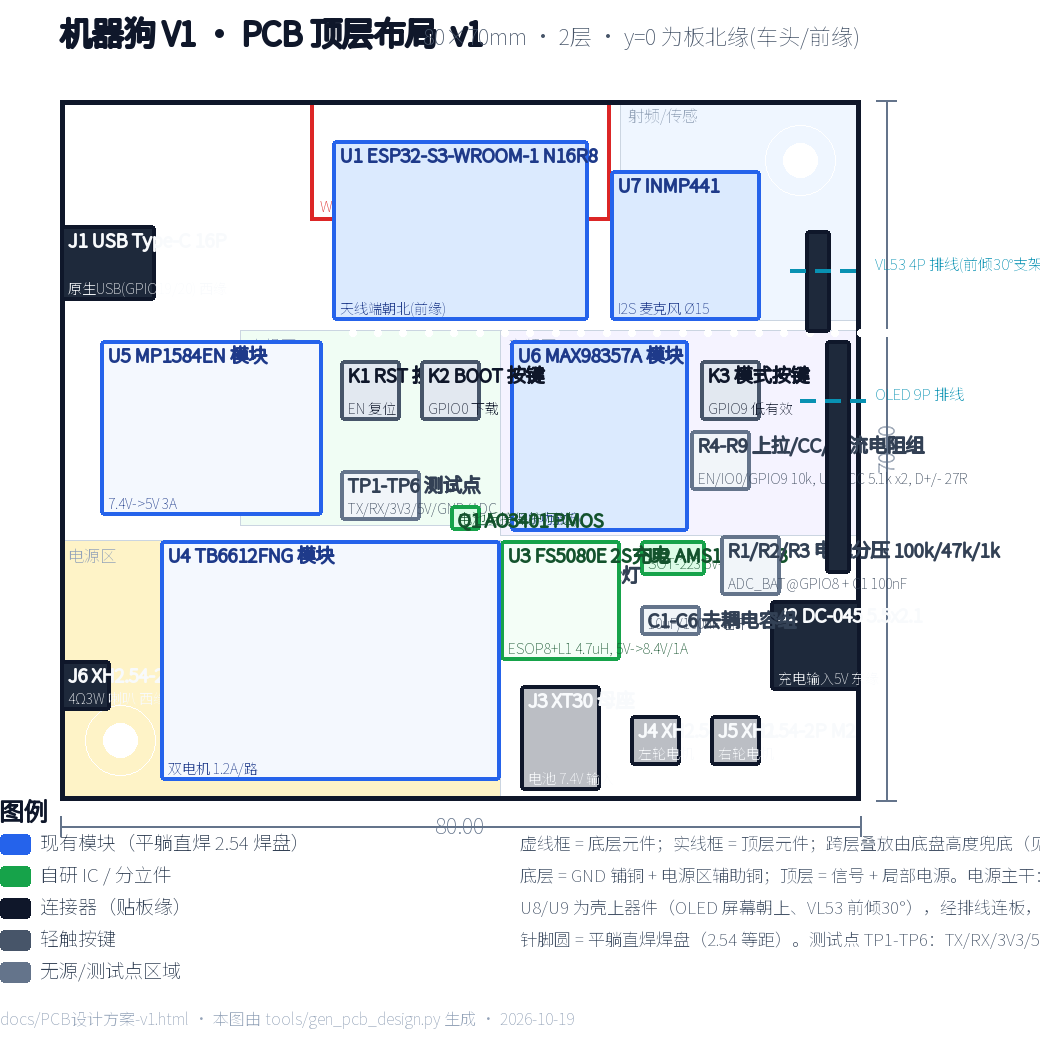
docs/source/pcb-layout-v1-preview.png
