MingMingL/little_dog/docs/source/pcb-layout-v2-bottom-preview.png

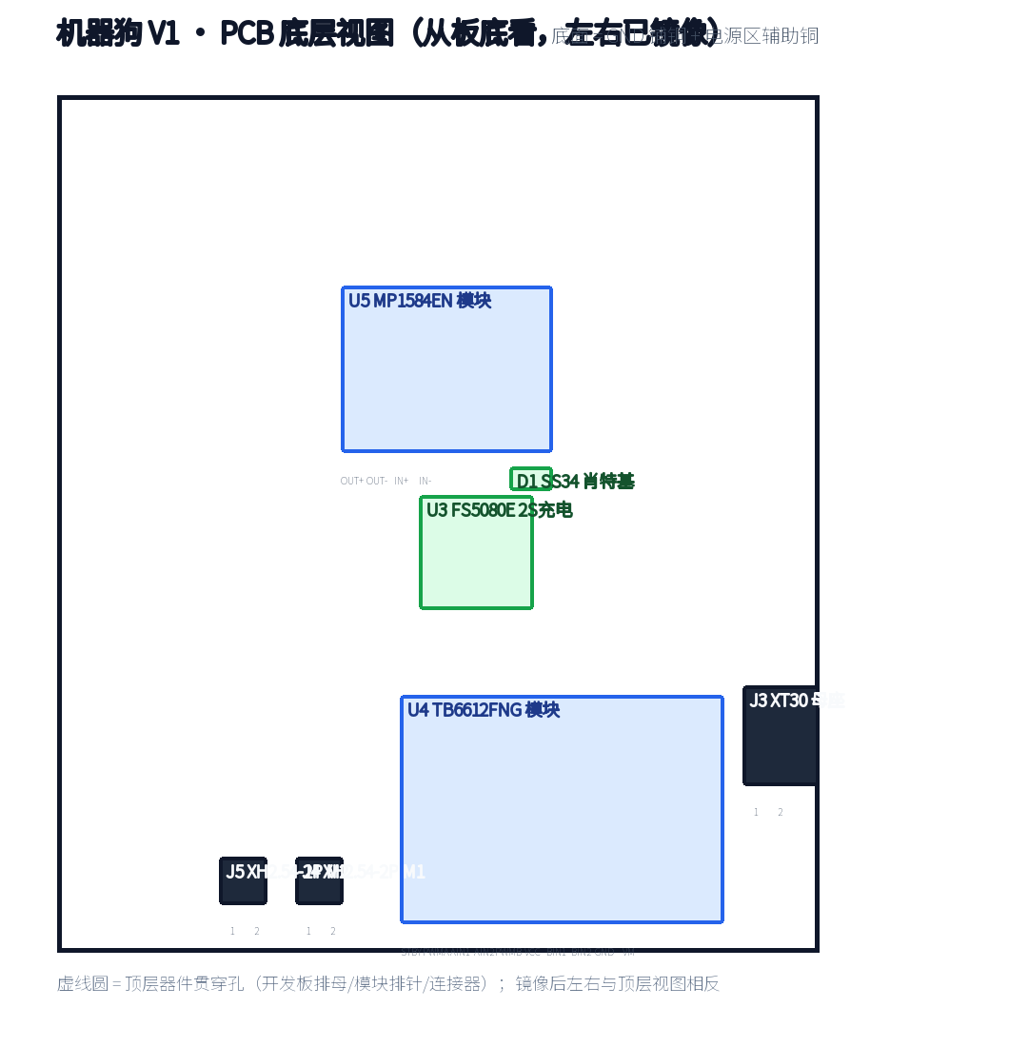
docs/source/pcb-layout-v2-bottom-preview.png
