MingMingL/little_dog/docs/source/pcb-layout-v2-preview.png

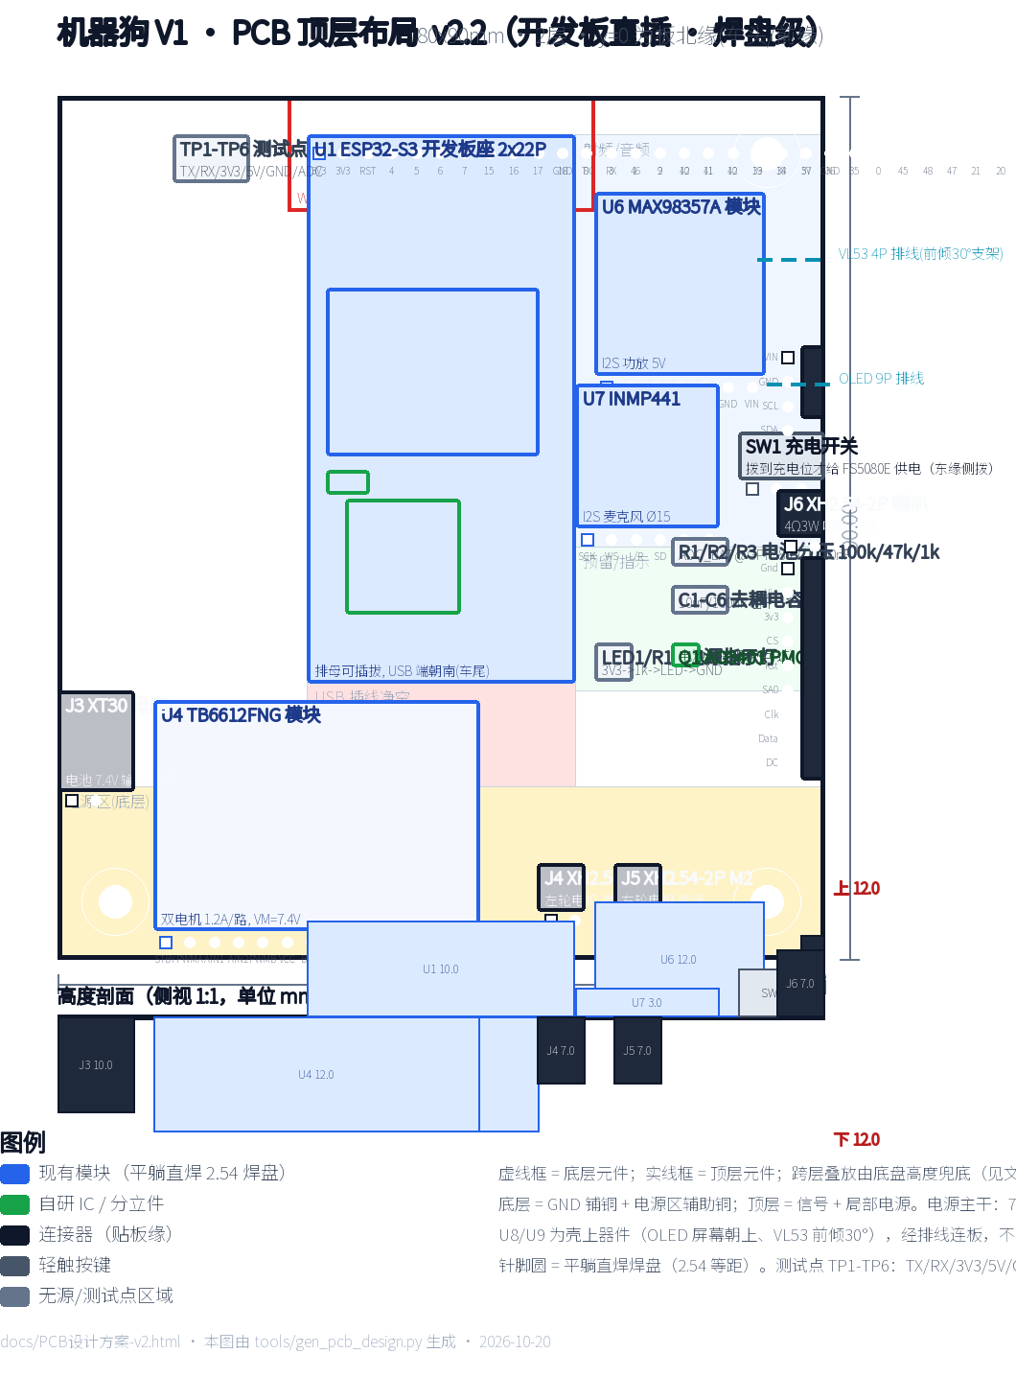
docs/source/pcb-layout-v2-preview.png
