MingMingL/little_dog/docs/source/schematic-preview-v1.png

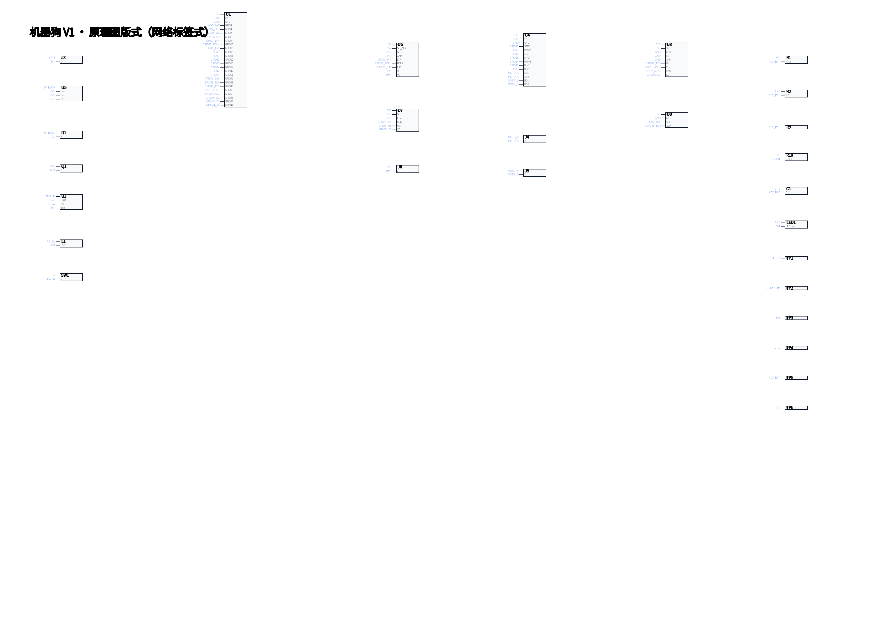
docs/source/schematic-preview-v1.png
