MingMingL/little_dog/docs/遥控界面-2026-10-15.png

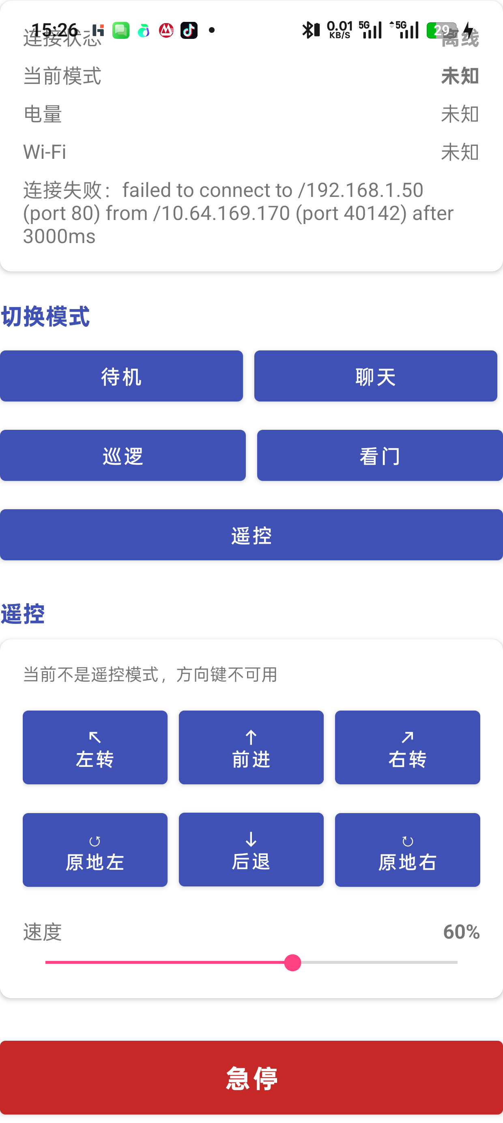
docs/遥控界面-2026-10-15.png
