MingMingL/little_dog/docs/source/pcb-outline-v2.dxf

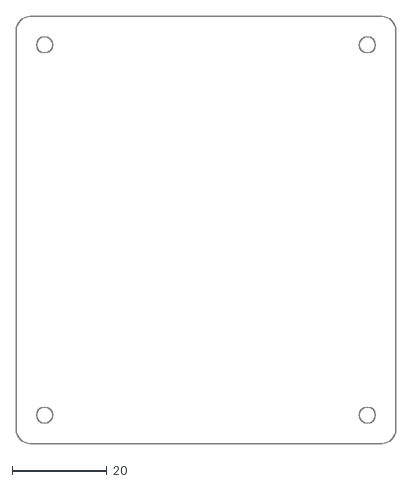
[picture p27: CAD file, 2026-10-20]
docs/source/pcb-outline-v2.dxf
80.0 x 90.0
