MingMingL/little_dog/(list of files, drawings)

Other design files:
docs/source/pcb-design-baseline-v1.json
docs/source/pcb-design-baseline-v2.json
