MingMingL/little_dog/docs/source/ai-dog-v1.kicad_sch

## KiCad design docs/source/ai-dog-v1.kicad_sch (2026-10-20)

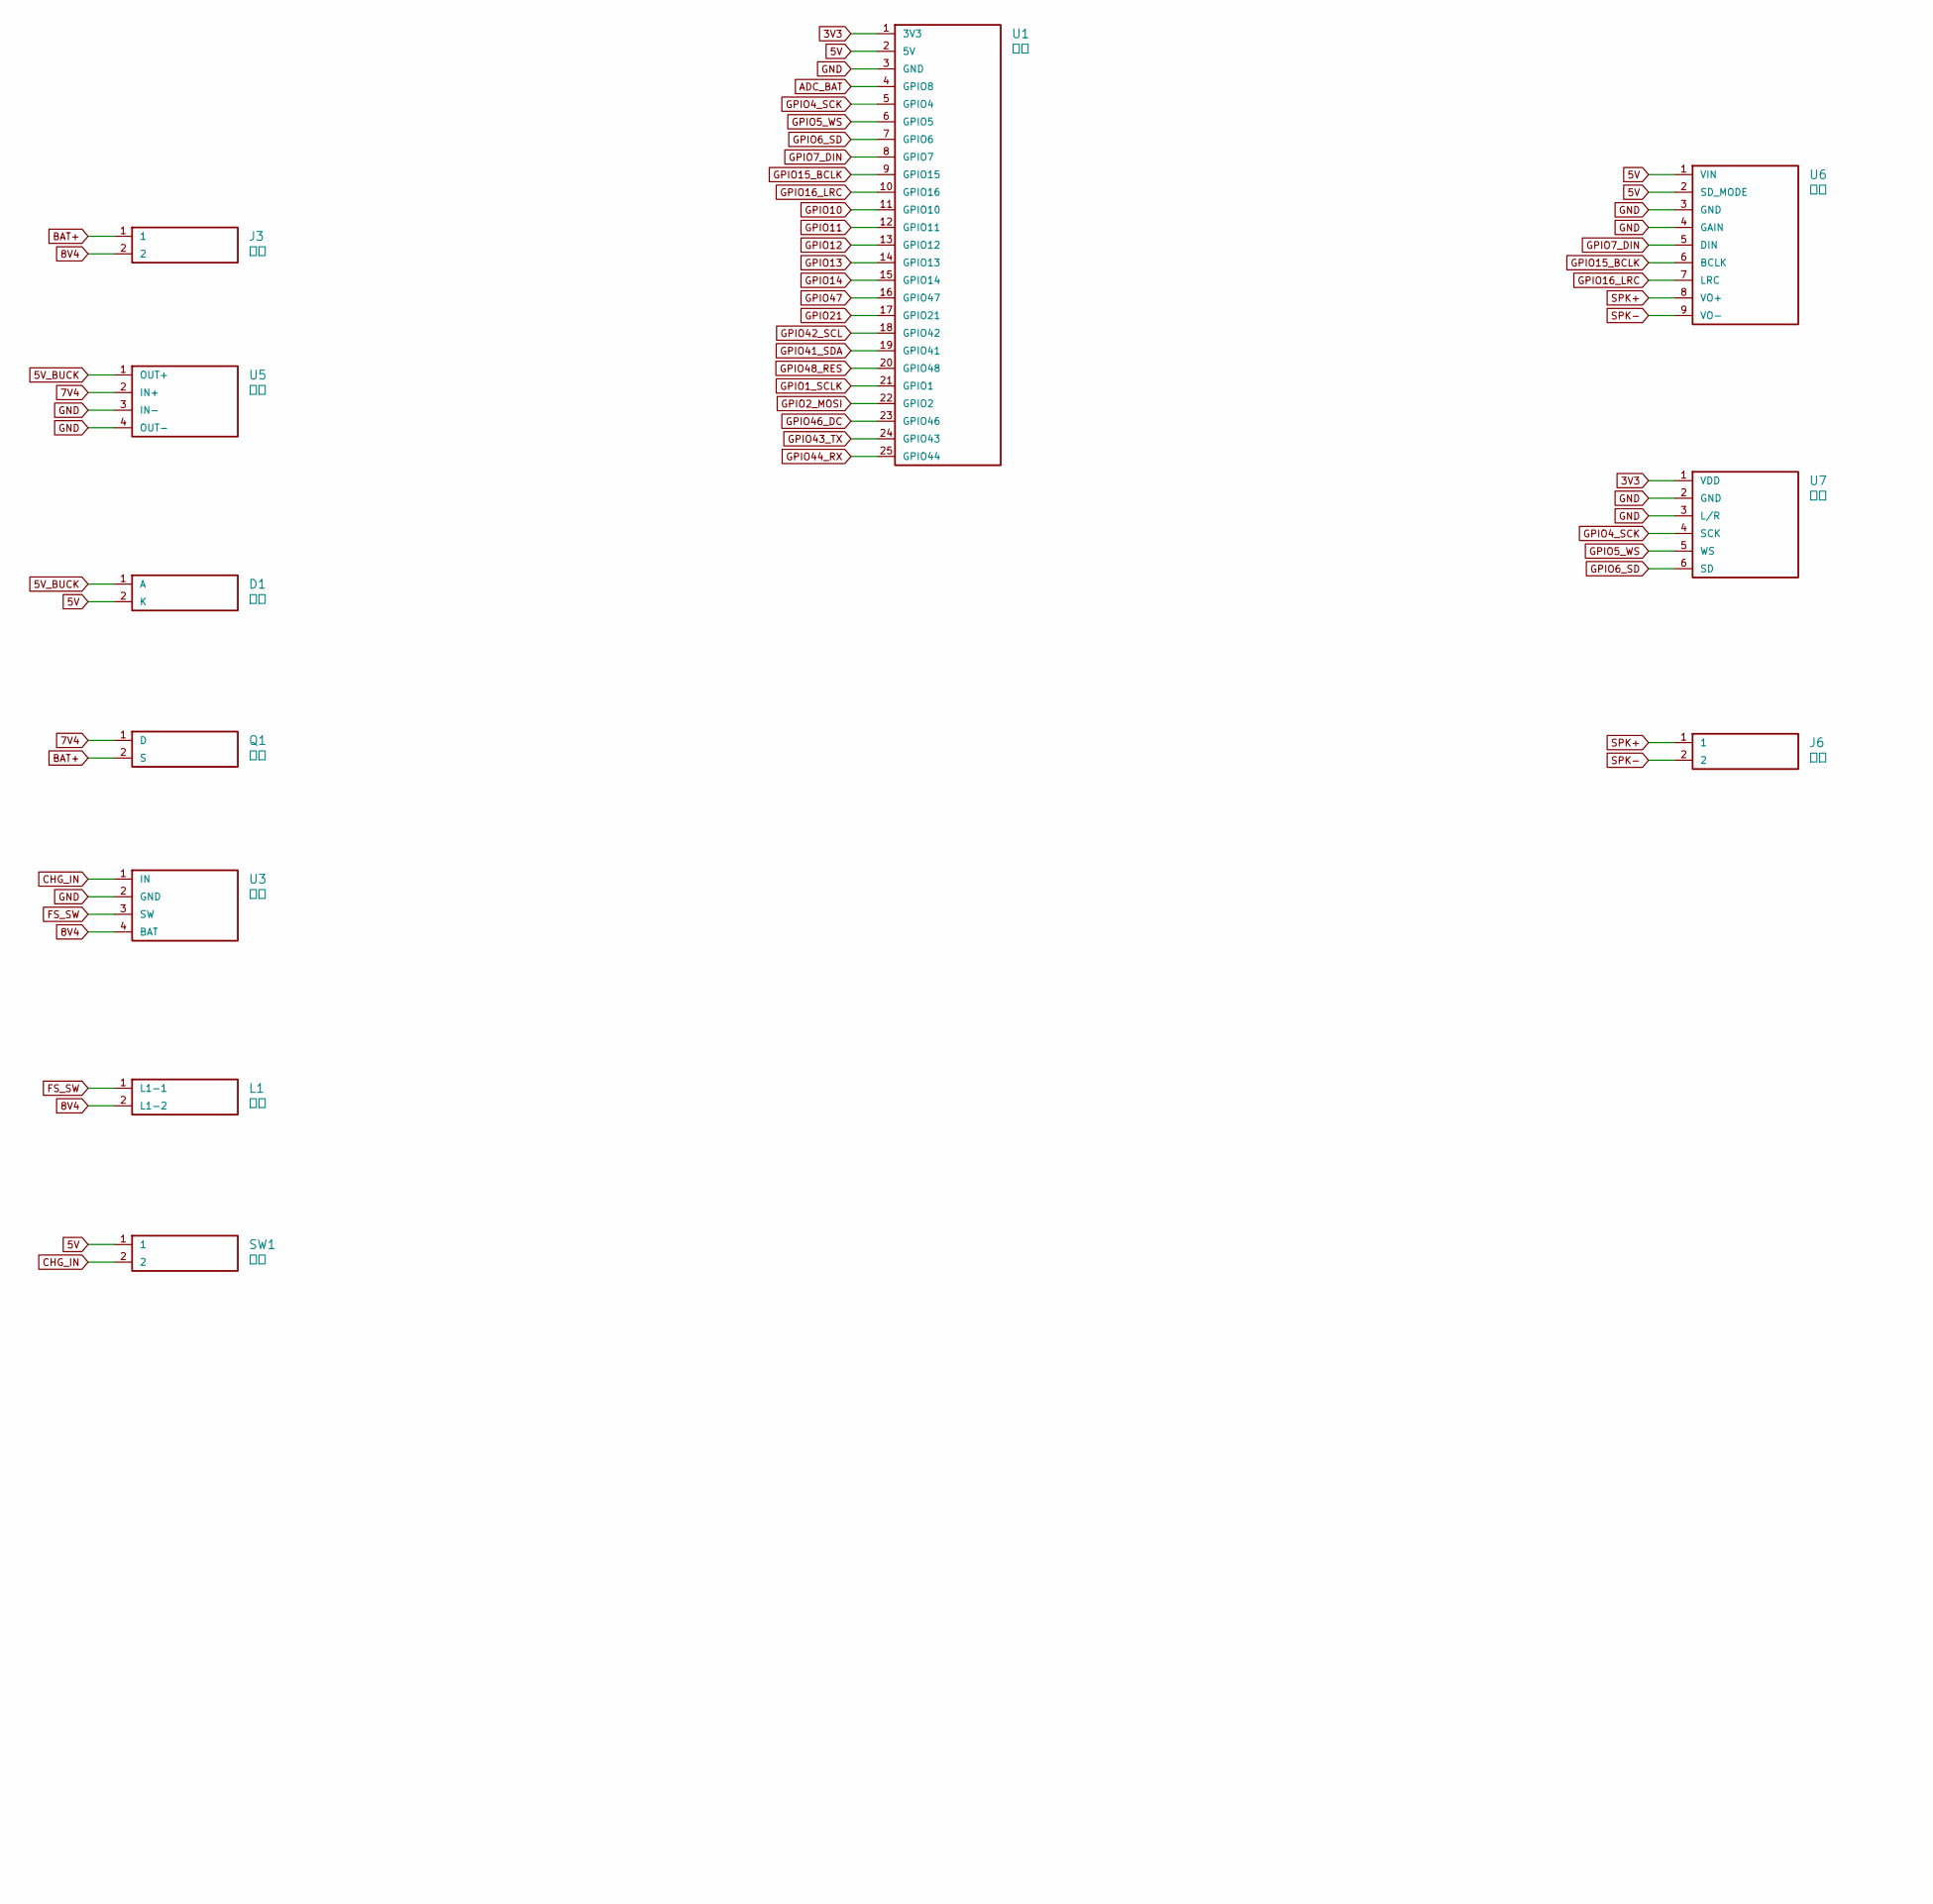
[picture p28: schematic ai-dog-v1.kicad_sch, part in row 1, column 1]

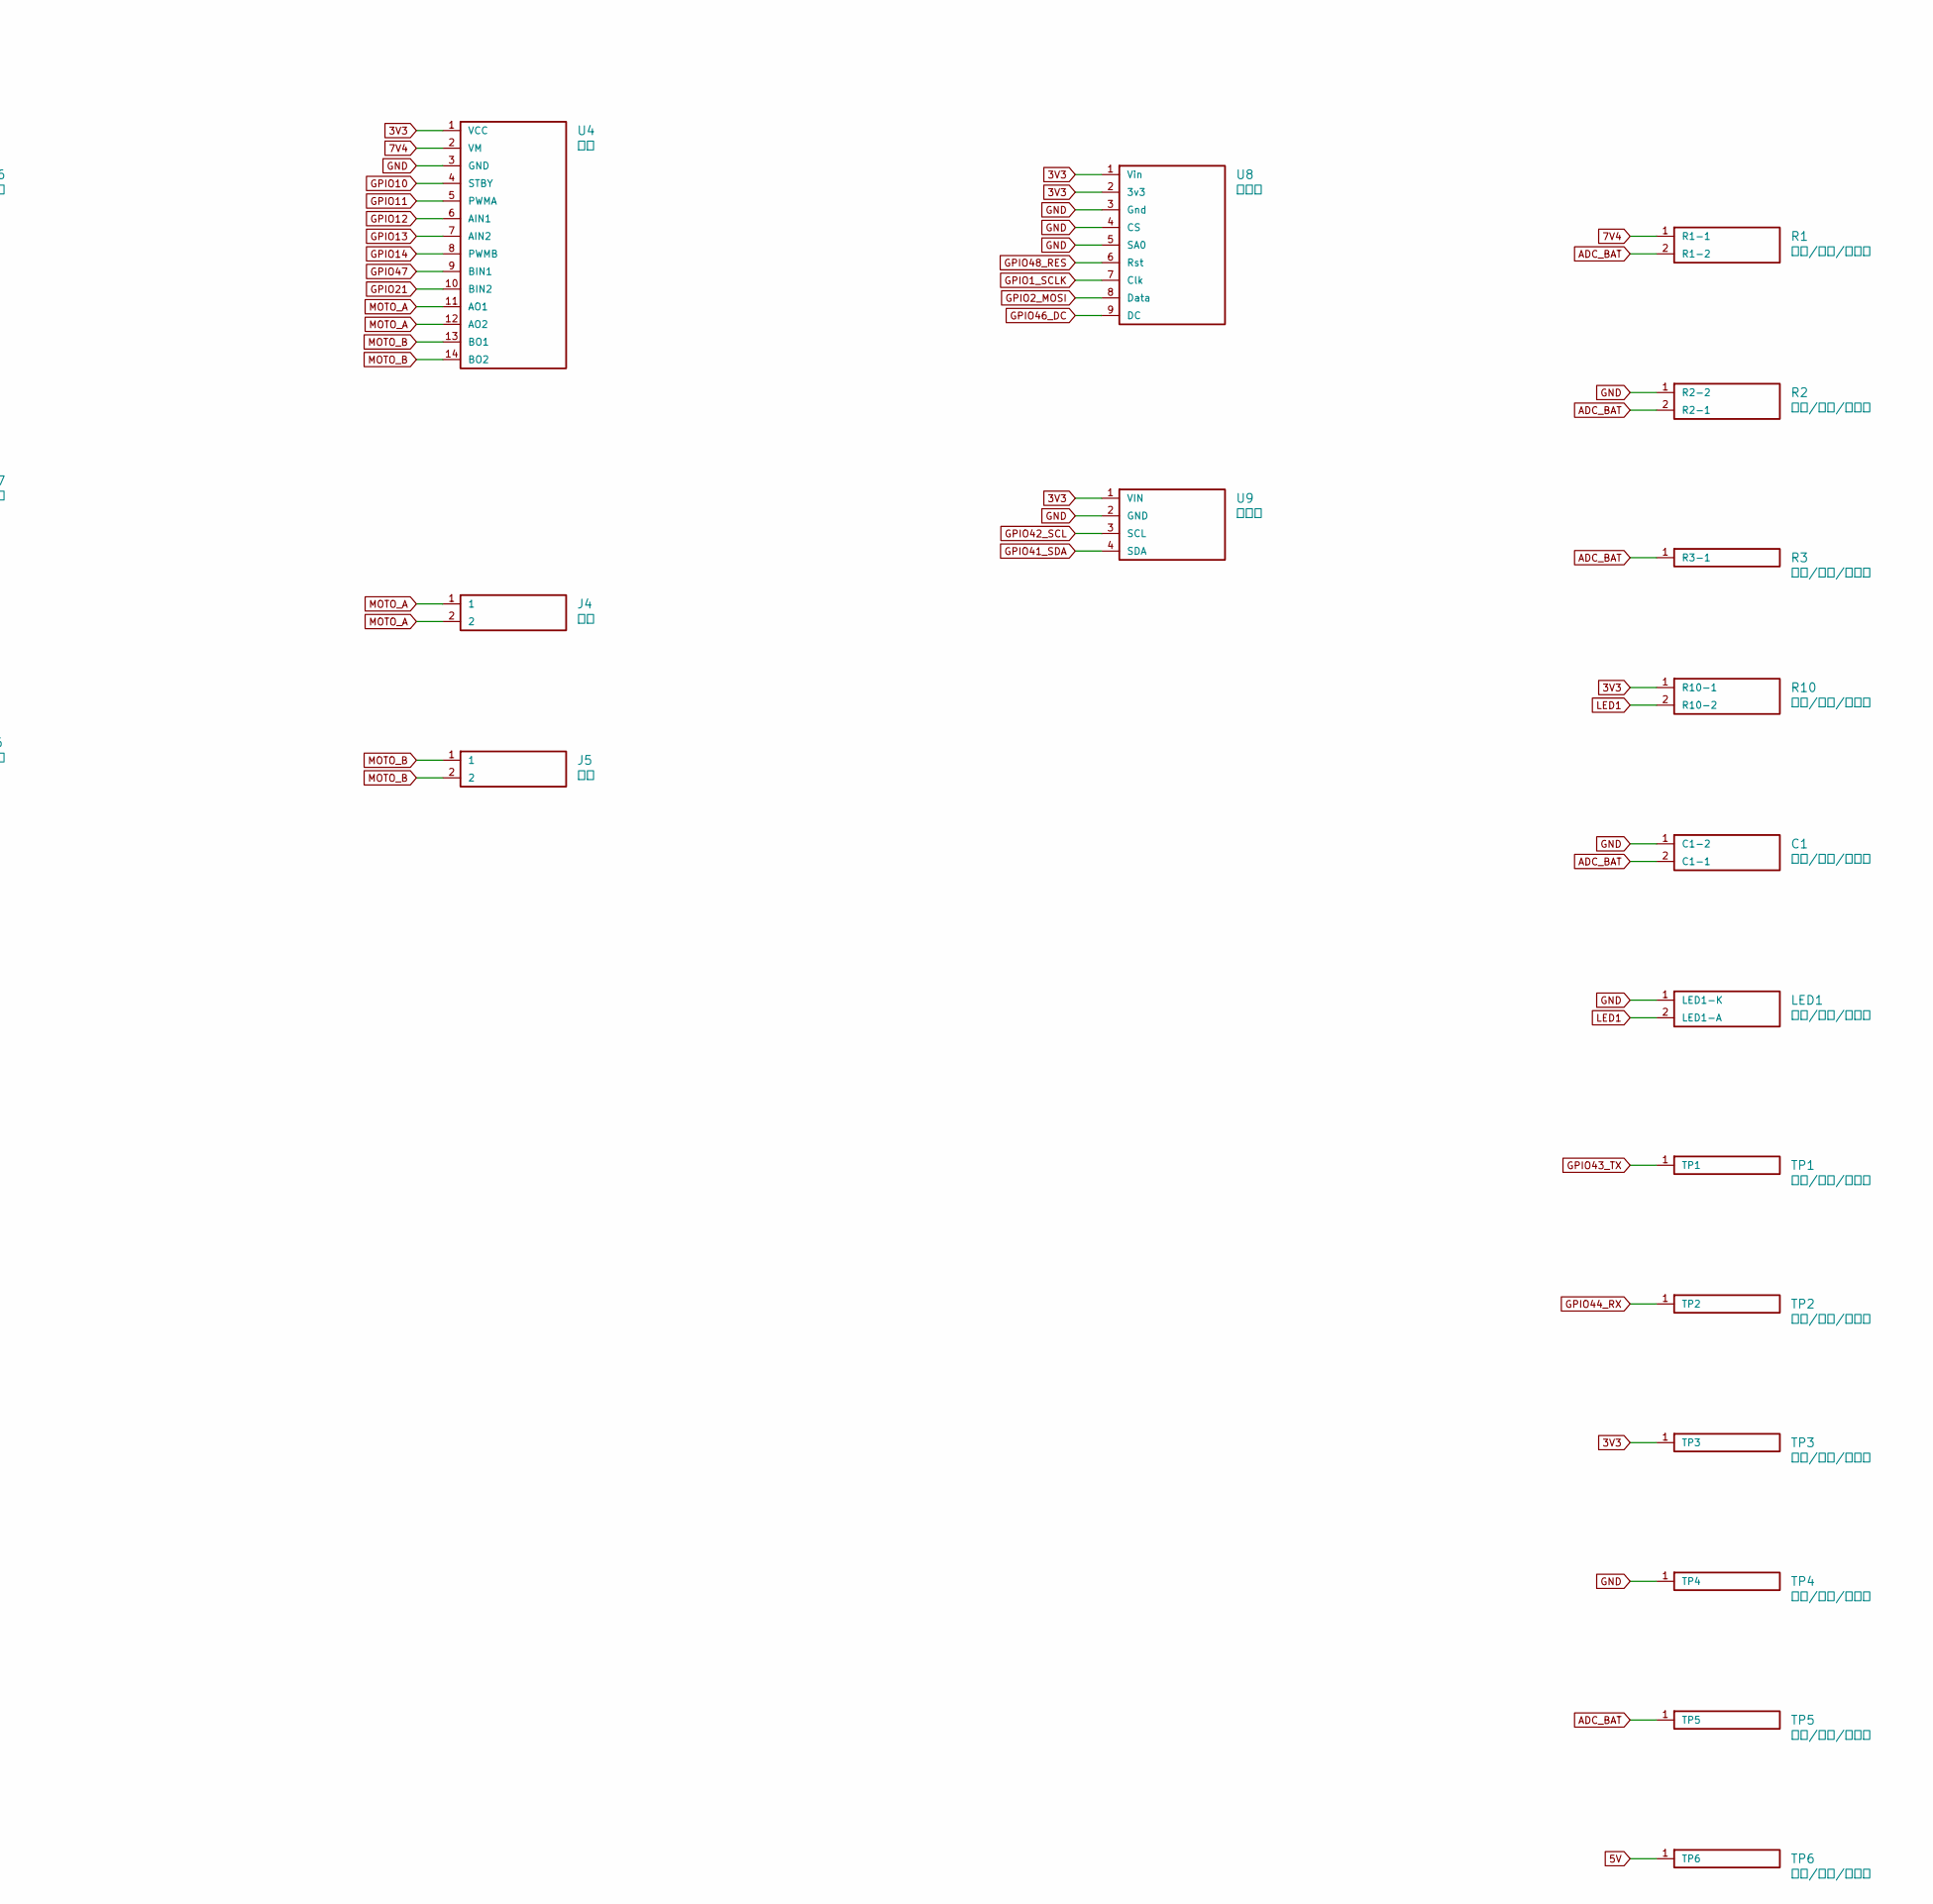
[picture p29: schematic ai-dog-v1.kicad_sch, part in row 1, column 2]

Parts:
C1: 分压/指示/测试点
D1: 电源
J3: 电源
J4, J5: 电机
J6: 音频
L1: 电源
LED1: 分压/指示/测试点
Q1: 电源
R1, R2, R3, R10: 分压/指示/测试点
SW1: 电源
TP1, TP2, TP3, TP4, TP5, TP6: 分压/指示/测试点
U1: 主控
U3, U5: 电源
U4: 电机
U6, U7: 音频
U8, U9: 传感器

Connections:
3V3: R10.1 (R10-1), TP3.1, U1.1 (3V3), U4.1 (VCC), U7.1 (VDD), U8.1 (Vin), U8.2 (3v3), U9.1 (VIN)
5V: D1.2 (K), SW1.1, TP6.1, U1.2 (5V), U6.1 (VIN), U6.2 (SD_MODE)
5V_BUCK: D1.1 (A), U5.1 (OUT+)
7V4: Q1.1 (D), R1.1 (R1-1), U4.2 (VM), U5.2 (IN+)
8V4: J3.2, L1.2 (L1-2), U3.4 (BAT)
ADC_BAT: C1.2 (C1-1), R1.2 (R1-2), R2.2 (R2-1), R3.1, TP5.1, U1.4 (GPIO8)
BAT+: J3.1, Q1.2 (S)
CHG_IN: SW1.2, U3.1 (IN)
FS_SW: L1.1 (L1-1), U3.3 (SW)
GND: C1.1 (C1-2), LED1.1 (LED1-K), R2.1 (R2-2), TP4.1, U1.3 (GND), U3.2 (GND), U4.3 (GND), U5.3 (IN-), U5.4 (OUT-), U6.3 (GND), U6.4 (GAIN), U7.2 (GND), U7.3 (L/R), U8.3 (Gnd), U8.4 (CS), U8.5 (SA0), U9.2 (GND)
GPIO1_SCLK: U1.21 (GPIO1), U8.7 (Clk)
GPIO2_MOSI: U1.22 (GPIO2), U8.8 (Data)
GPIO4_SCK: U1.5 (GPIO4), U7.4 (SCK)
GPIO5_WS: U1.6 (GPIO5), U7.5 (WS)
GPIO6_SD: U1.7 (GPIO6), U7.6 (SD)
GPIO7_DIN: U1.8 (GPIO7), U6.5 (DIN)
GPIO10: U1.11 (GPIO10), U4.4 (STBY)
GPIO11: U1.12 (GPIO11), U4.5 (PWMA)
GPIO12: U1.13 (GPIO12), U4.6 (AIN1)
GPIO13: U1.14 (GPIO13), U4.7 (AIN2)
GPIO14: U1.15 (GPIO14), U4.8 (PWMB)
GPIO15_BCLK: U1.9 (GPIO15), U6.6 (BCLK)
GPIO16_LRC: U1.10 (GPIO16), U6.7 (LRC)
GPIO21: U1.17 (GPIO21), U4.10 (BIN2)
GPIO41_SDA: U1.19 (GPIO41), U9.4 (SDA)
GPIO42_SCL: U1.18 (GPIO42), U9.3 (SCL)
GPIO43_TX: TP1.1, U1.24 (GPIO43)
GPIO44_RX: TP2.1, U1.25 (GPIO44)
GPIO46_DC: U1.23 (GPIO46), U8.9 (DC)
GPIO47: U1.16 (GPIO47), U4.9 (BIN1)
GPIO48_RES: U1.20 (GPIO48), U8.6 (Rst)
LED1: LED1.2 (LED1-A), R10.2 (R10-2)
MOTO_A: J4.1, J4.2, U4.11 (AO1), U4.12 (AO2)
MOTO_B: J5.1, J5.2, U4.13 (BO1), U4.14 (BO2)
SPK+: J6.1, U6.8 (VO+)
SPK-: J6.2, U6.9 (VO-)
