MingMingL/little_dog/(commit log)

2026-10-14 Initial commit: docs, Android control app, PRD, wiring plans (v1-v5)
2026-10-14 Import firmware (xiaozhi-esp32 + ai-dog-s3 board): 4 commits from local firmware repo
    - 5ccd7f1 Initial xiaozhi-esp32 with ai-dog-s3 custom board
    - deab432 LAN control server (HTTP API: status/mode/stop/wifi)
    - ba31813 Add SSD1306 OLED (7-pin SPI) display support
    - 9e01776 Fix OLED driver: SH1106 for 1.3-inch panel
    [16m.csv, 16m_c3.csv, 16m_custom_wakeword.csv, 16m_echoear.csv, 32m.csv, 4m.csv, 4m_esp-hi.csv, 8m.csv]
2026-10-14 Add voice mode-switch via MCP tool (self.dog.set_mode)
    - 语音控制模式切换：LLM 调用设备端 MCP 工具
    - patrol/guard 需二次确认；与 App 最后到达者优先
    - 同步更新协议文档 2.5 节
2026-10-14 docs: 硬件接线方案 v6 —— 澄清'两个 2WD 电机'指一套底盘含左右两台电机
2026-10-15 Fix Android control app: 侧滑无法退出 + ActionBar 遮挡按钮
    首页侧滑/返回键无法退出 App：根因是 MainActivity.onResume() 在 IP 为空时
    无条件 startActivity(SetupActivity)，导致用户在设置页（也就是首次打开看到的
    第一个页面）侧滑返回后，MainActivity.onResume 立刻把设置页重新拉起来，Activity
    被反复重建，表现为“侧滑多少次都退不出”。Android 15 edge-to-edge（targetSdk 36）
    把这个死循环变得肉眼可见。
    改法：把无 IP 时的设置页引导改成 onCreate 里走 ActivityResultLauncher 拉起，
    回调里若 IP 仍为空就 finish() 主界面 → 侧滑/返回键正常退出。SetupActivit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
2026-10-15 docs(android): 注明启动流程用 ActivityResultLauncher，避免 onResume 死循环
    配合上一个 bug 修复：早期版本 onResume 无条件拉起 SetupActivity 会让侧滑/返回
    被死循环吃掉、App 永远退不出去。这里在设计文档里写明正确做法，防止以后误改回
    onResume 拉起的老写法。
2026-10-15 feat(firmware): 遥控运动接口 /api/move + TB6612 电机驱动 + 新增 remote 模式
    设备端从「只有状态上报」变成真能驱动电机。
    新增：
    - ai_dog_motor.{h,cc}：TB6612 双路驱动，LEDC PWM 20kHz/8bit（超出人耳听感避免啸叫）。
    只做「左右轮速度 -> 电平/PWM」的翻译，不做任何决策；所有写 GPIO 的方法加锁，
    因为 HTTP 回调线程和看门狗定时器线程会并发调用 Stop()。
    - Mode 枚举加 Remote（字符串 remote）；/api/move 收 dir + speed，只在 remote 模式接受。
    安全设计（三层停车，缺一不可）：
    1. App 松手 / 退后台发 stop；
    2. 设备端看门狗：remote 模式下 1.5s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
2026-10-15 feat(android): 遥控界面 —— 按住方向键持续走、松手即停
    新增「遥控」模式（第 5 个模式按钮，独占一行）+ 遥控卡片：6 个方向按钮
    （左转/前进/右转、原地左/后退/原地右）+ 速度滑块（默认 60%）。
    交互用 OnTouch 而不是 OnClick：遥控要的是「按住持续走、松手停」，点击事件只有
    按下没有持续。按住期间按 10Hz 重复发同一条指令，MOVE_REPEAT_MS = 100。
    ACTION_CANCEL 也必须停 —— 手指滑出按钮边界时系统只给 CANCEL，漏掉它狗会一直跑。
    DeviceApi.move() 的关键取舍：允许丢包、不允许堆积。这条指令是「按住持续走」语义，
    网络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
2026-10-15 docs+tools: 遥控协议说明 + 无硬件时用的设备模拟器
    - docs/Android控制端设计.md：
    - 新增 2.4 节遥控运动协议（dir 7 个取值、speed 0..100 缺省 60）；
    - 明确 /api/move 只在 remote 模式被接受，以及三层停车保护；
    - 状态字段 mode 补上 remote；App / 设备端结构表补遥控相关文件；
    - 修正章节编号（新增 2.4 后原 2.5/2.6 顺延为 2.7/2.8）。
    - tools/sim_dog.py：设备端模拟器，实现 status/mode/move/stop 四个接口，拒绝逻辑与
    真机一致。用法：python tools/sim_dog.py 8080 + adb reverse tcp:8080 tcp:8080，
    把 App 设备 IP 临时填成 127.0.0.1:8080，即可在没有硬件时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
    [sim_dog.py]
2026-10-15 docs: 补遥控界面实拍图
    真机截图 docs/遥控界面-2026-10-15.png：模式区多了「遥控」独占行，
    遥控卡片含 6 个方向键（左转/前进/右转、原地左/后退/原地右）+ 速度滑块 60%。
    图中设备离线，所以遥控提示显示"当前不是遥控模式，方向键不可用"。
2026-10-15 fix(android): 停车指令不再被 10Hz 运动请求吞掉 + 状态监听加代数标记
    复审遥控实现时发现两个真问题，都不是"看起来能跑"就能暴露的：
    1. 停车可能丢（安全相关）。原实现里 move() 只要发现上一条请求在途就直接 return，
    而 stop 走的也是同一条路径 —— 也就是说 10Hz 的运动请求正好占线时，松手 / onPause
    发出的 stop 会被静默丢掉，此时重复发送循环也已经取消，**不会再补发**，
    只剩设备端看门狗 1.5s 后兜底。现在停车例外：保留一条 pending stop，
    上一条请求结束后优先下发（先发 stop 再回调旧指令，避免回调又发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
2026-10-15 fix(firmware/tools): 构建脚本不再掩盖失败 + 模拟器对齐固件语义
    build-ai-dog.ps1：
    - Invoke-Idf 改为每次调用后立刻检查 $LASTEXITCODE 并抛错。原实现把成败判断放在
    脚本末尾，`set-target` 失败会被紧随其后的 `build` 覆盖掉，最终以 build 的退出码
    收尾 —— 于是"目标都没设成功"被报成"编译成功"。
    - 用 try/finally 恢复 $ErrorActionPreference，避免异常路径下把 Continue 泄漏出去。
    - 加 CCACHE_DISABLE=1：ccache 又多一条工作区外的临时路径，首次构建毫无收益。
    tools/sim_dog.py（设备模拟器，用来在没有 TB6612/底盘时验证遥控链路）：
    - uptime 从 time.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
    [sim_dog.py]
2026-10-15 docs: 架构说明 v4（遥控安全与构建配置优化）+ 忽略 output 下的 APK
    - 新增 docs/代码架构与改动说明-v4.html：按项目版本化规则复制 v3 新建，v3 保留不覆盖；
    改动部分绿框标注，修改历史表登记本轮四项改动（DeviceApi 停车/代数、build.gradle
    依赖约束、构建脚本退出码、模拟器语义）。
    - .gitignore 增加 output/*.apk：output/ 是暂存/交付目录，里面的 debug APK 有 7.5MB，
    属构建产物，不该进仓库（要归档版本请用 tag + 重新构建）。
    注意：output/代码架构与改动说明-v4.html 与 docs/ 下那份字节完全相同（md5 一致），
    是本地重复产物，未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
2026-10-15 docs: 硬件接线方案 v7（830 点单板 + 逐级上电验证教程 + 回归电池供电）
    - 硬件资源修正：用户只有一块 830 点（63 列）面包板，撤销 v3 起按 400 点写的布局；模块改为直插+公对公跳线列对列，母对母夹顶仅留 OLED 4 信号与 TB6612 6 信号
    - 新增第二节小白逐级上电验证教程：万用表三用法、MP1584 六步调压 5.00V、限流三手段、十步上电验证（每步量什么/期待值/异常处置）、电流记录表、冒烟应急
    - 勘误：面包板主区为同列同半区 5 孔相通（v3-v6 误写为横排 5 孔）
    - ESP32 5V 改 MP1584 直连（v6 走轨，Wi-Fi 峰值 350mA 会拖垮轨）；面包板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
2026-10-15 refactor: 去除重复逻辑与死代码，精简构建脚本配置
    Android:
    - 新增 Prefs 统一设备 IP 的 SharedPreferences 文件名与 key（原先两个 Activity 各写一套）
    - DeviceStatus.modeLabel 增加静态重载，MainActivity 不再复制一份模式名映射
    - DeviceApi 抽出 enqueuePost，/api/move 不再复制整段 POST 与成功判定逻辑
    - 模式按钮改表驱动（modeButtons），打 tag 与高亮共用同一份映射，删除 5 分支 if-else
    - 5 处硬编码中文提示移入 strings.xml（含 SetupActivity 的校验与配网失败提示）
    固件（boards/ai-dog-s3）:
    - 删除零调用的 MoveDirectionToString 与 IsRunning
    - 抽出 ParseJsonBody / SendOk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
2026-10-16 docs: 面包板 Z 双 830 拼接规划图（先轮廓，后全量插孔）
    - 拓扑：X（上板，终端行 a-j）+ Y（下板，终端行改名 k-t）沿电源轨长边拼接，Z = 28 行 x 63 列；
    拼接缝处两板导轨仅物理相邻、电气不互通。
    - tools/gen_breadboard_z.py 参数化生成；几何照抄 breadboard.svg（mm 单位、同配色字体）。
    - breadboard-z.svg 分 #z-outline / #z-holes 两组，可单独隐藏插孔复看轮廓；
    breadboard-z-outline.svg 为纯轮廓版。
    - 新增 tools/svg_to_png.py：Pillow 渲染 SVG 子集为 PNG 做视觉校验（本机无 cairo/rsvg）。
    - 修复并防回归：孔分组漏挂板体 translate 会导致两板孔重叠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
    [gen_breadboard_z.py, svg_to_png.py]
2026-10-16 docs: 面包板 Z 第三步——ESP32-S3 N16R8 插入拼接缝中央
    - 元件几何从面包板 SVG 原样导出为 tools/data/esp32s3_n16r8_component.svg，generator 读取嵌入
    - 44 针全部落在 X 板 j 行 / Y 板 k 行 22-43 列（J1 上排、J3 下排），元件中心正压拼接缝
    - 插孔三态：free 1540 / occupied 44 / blocked 76（板身遮挡的靠缝导轨孔，浅灰叠加显示）
    - 图例补 ESP32 插入说明与孔三态；接缝标签避开板身，缝线叠加到元件之上
    - validate() 升级为通用仿射变换，逐针校验落位与孔态
    - svg_to_png.py 支持 rotate/绕点旋转与旋转文字（标记像素法定枢轴）
2026-10-16 修正面包板 Z 图中 J1/J3 标注（USB 朝右，按官方 pinout）
    上一轮把 J1/J3 丝印标反了：官方 user guide v1.1 中 J1=3V3/RST/GPIO4-14/5V/GND 侧、
    J3=GND/TX/RX/GPIO1-2/42-19/GND 侧；按元件几何（USB 朝右时 J1 排针在局部低 x 端）
    上排针属 J3 落 X 板 j 行、下排针属 J1 落 Y 板 k 行，与"J1→j、J3→k"的表述互为镜像。
    经用 data-pin 逐针核对 44 针确认无误。
    按用户决定保持 USB 朝右（物理取向不动，只改文字）：
    - gen_breadboard_z.py / 元件数据文件：引线标注与图例中 J1/J3 互换，补官方 pinout 说明
    - 板右侧新增两行引脚序列速查（j/k 行各 22 针，左->右 = 列 2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
    [esp32_pin_map.py, gen_breadboard_z.py]
2026-10-16 docs: 面包板 Z 第四步——ESP32 右移 10 列 + 元件 2/9 MAX98357A 功放与喇叭
    - ESP32-S3 右移 10 列（列 22-43 -> 32-53，用户指令"其他不变"）：transform 改 137.8，
    板身 x[80.65,137.8] 仍压缝心；INMP441 落孔随动 m25/26/27/22 -> m35/36/37/32（ctrl x +25.4）；
    esp32_pin_map.py 同步修正（原写死旧平移 112.4，GPIO 落列整体偏 10 列）
    - 挡孔改动态计算 dev_blocked_rail_names()（列 32-53 时 18 孔/轨 x4 = 72），图例与校验全改动态计数
    - 元件 2/9 MAX98357A（用户决策：7 针、SD_MODE->VIN、GAIN->GND、喇叭画示意符号）：
    几何抄 docs/source/MAX98357A.svg；7 针插 q 行 45-51，LRC/BCLK/DIN -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
    [esp32_pin_map.py, gen_breadboard_z.py, svg_to_png.py]
2026-10-16 面包板 Z 元件 3/9：TB6612FNG 双路电机驱动（板外模块）
    - 用户三项决策落位：BIN1/BIN2 落 X 板 i 行 48/49；模块图示=方框+丝印；电机画示意符号 M1/M2。
    - 落孔 9 个：STBY/PWMA/AIN1/AIN2/PWMB 落 Y 板 l47-l51（GPIO10-14，m/n/o 45-51 被 MAX
    本体挡死、k47-51 是 ESP32 针，l 行唯一合法行）；BIN1/BIN2 落 X 板 i48/i49（GPIO47/21，
    同列 f-i 同网）；VCC 落 o32（3V3）；GND 落下轨外轨第 44 孔。
    - 模块本体板外方框 x[92,126] y[63,87]（VM 4.5-10V 与 1A+ 电机电流绝不上面包板），
    VM 接 7.4V 电池符号，AO1/AO2、BO1/BO2 接电机 M1/M2；图例整体下移 +36 腾出板外区，
    CANVAS_H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
2026-10-16 面包板 Z 元件 4/9：TCRT5000x5 五路巡线（用户决策：分散阵列、VCC 接 3V3）
    - config.h：GPIO17/18=k41/k42（Y 板网）、38/39/40=j41/j40/j39（X 板网），全板无空闲
    j/k 脚可对调；单列 4 针竖插会整列同网短接（铁律）-> 只能横躺占 4 连续列。
    - 死结：5 个探头本体各 24.15mm 而 GPIO38/39/40 在 j 行相邻列，直接落网列本体重叠。
    解法=探头分散 + DO 针跳线到 GPIO 同列网孔（跳线两端可任意孔）。
    - 排布：TCRT1 (Y n20-23, GPIO17->跳线 l41)、TCRT2 (Y o33-36, GPIO18->pts 跳线 l42)、
    TCRT3 (X f27-30, GPIO40->i39)、TCRT5 (X f39-42, GPIO38 f41 与 j41 同列直连零线)、
    TCRT4 (X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
2026-10-16 面包板 Z 元件 5/9：VL53L0X 前向测距（用户决策：板外上方窗朝北、XSHUT/GPIO 悬空）
    - config.h：SDA=GPIO41=j38、SCL=GPIO42=j37（网在 X 板 f-i 行列 38/37）。
    - Adafruit rev C：板身 27.24x17.78、单排 6 针 VIN/GND/SCL/SDA/GPIO/XSHUT；板高超半区
    行带（10.16）-> 本体悬板外上方（用户决策），6 针横躺落 a 行列 35-40，挡 top_* 26-34
    共 18 孔。
    - SCL/SDA 走 pts 竖带（38/39 缝 x=99.06、39/40 缝 x=101.6），经 h/i 行间缝入 i37/i38
    与 j37/j38 同列同网；贝塞尔初版失败（扫 38 列孔串）已弃。
    - VIN->top_inner_25、GND->top_outer_23：贝塞尔先北上离 a 行孔带再贴本体西南板身角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
2026-10-16 refactor: 文案资源化与路由表收口，清理死代码与死开关
    Android：
    - 布局 5 处硬编码中文收进 strings.xml（device_ip_value/value_none/section_status/section_remote/speed_value）
    - 默认速度单点定义：SeekBar progress -> currentSpeed，删掉 Java 常量与文案初值里的重复 60
    - DeviceApi 抽出 MSG_NO_IP 常量（原先 3 处各写一遍）
    - 删除零引用颜色 text_primary；高亮时不再重复设置相同的文字颜色
    固件：
    - 5 个 httpd_uri_t 结构体改为 routes[] 路由表循环注册（URI/method/handler 不变）
    - build-ai-dog.ps1 移除 IDF_PY_BUILD_JOBS（构建已直接调 ninja，该变量不再被读取）
    工具：
    - gen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
2026-10-18 feat(ai-dog-s3): 电池监测 + 复位原因 + 设备本地日志
    解决"电池供电时反复重新初始化、但当时没有串口看不到现场"的问题。
    - ai_dog_diag.{h,cc} DeviceLog：esp_log 钩子 -> 96 条内存环 ->
    doglog 分区落盘；flash 是 256B 定长环形记录（magic + 单调序号 +
    uptime + 级别 + 复位原因 + 文本），启动时按序号排序 dump 到串口。
    esp_reset_reason() 中文映射，brownout 单独告警。
    - ai_dog_battery.{h,cc} BatteryMonitor：GPIO8/ADC1_CH7 + 电阻分压，
    输出电压与百分比；四档 Normal/Warn/Restrict/Cutoff，
    Restrict/Cutoff 需连续 3 次确认才生效（防 ADC 抖动误关机）。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
    [16m.csv]
2026-10-18 chore(main): 复位原因与音量日志补充
    工作区里已存在的改动，非本次 ai-dog-s3 开发的一部分，单独提交以便审查和回退。
    - application.cc：新增 ResetReasonToString()，启动时打印上次复位原因
    （含 ESP32-S3 的 brownout 码表说明）。排查偶发重启用。
    - audio_codec.cc：AudioCodec::Start() 现在把 output_volume / input_gain
    一并打出来，并区分"未存过用默认值"与"NVS 恢复"，
    避免重启后音量被静默加载这件事在日志里看不出来。
2026-10-19 refactor: 收口模式名与模式刷新，清理死分支与硬编码文案
    - MainActivity 抽 applyMode()：切模式/状态推送/急停三处都要"记状态+高亮+刷提示"，
    以前三处各写一遍，漏掉 updateRemoteHint 就会出现提示与模式不一致
    - DeviceApi 去掉 org.json，配网响应统一用 Gson 解析（两套 JSON 库并存是纯负担）；
    getStatus 只服务降级轮询，收为私有
    - 设置页 3 处硬编码中文资源化；删掉没有引用方的 hint_remote
    固件:
    - ModeToString / ModeFromString 合并为单一模式名表 kModeNames，加模式只改一处
    - Start() 删掉恒为 true 的 started 标志与不可达分支（失败路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
2026-10-19 撤销 TCRT 巡线阵列，VL53L0X 改前倾 30 度防跌落
    用户决策 B（2026-10-19）：TCRT5000 模块镜头在 PCB 正面，插面包板后朝上照不到地板；
    且量程仅 0.2-15mm，底盘一离地即超程，物理上无法完成巡迹/防跌落。
    - 生成器：删除 make_tcrt() 与 TCRT1-5（本体挡孔 134 + 落孔 33 退回），
    COMPONENTS 移除 5 项；VL53L0X 标注改前倾 30 度（d = h/tan30 ≈ 1.7h），
    新增 vl53_side_view() 侧视小图；图例/标题/账目同步
    账目 occupied 86 / blocked 135 / free 1439
    - wire_check.py：删除 15 条 TCRT 白名单与 startswith("tcrt") 分支；
    校验输出与改造前一致（15 根既有问题，无新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
    [config.h, gen_breadboard_z.py, wire_check.py]
2026-10-19 feat(breadboard): 元件 6 OLED 1.3" 接入 + 假短路检测
    元件 6 OLED（SH1106 SPI，9 针单排）已接入面包板 Z 规划图，本体放板外飞线、屏幕朝上。
    几何刚性结论：模块 9 针跨度 20.3mm，而 GPIO48(Rst)->j47 与 GPIO1/2(Clk/Data)->j35/j36
    跨 12 列 30.5mm，任何起列/翻转都插不进面包板 -> 本体必须放板外（off_board，不占孔不挡孔）。
    飞线穿轨三规则（v10 定型）：
    1. 正下方有轨孔 -> 绕到外轨以北空档沿列间缝穿轨（离两侧轨孔各 1.27mm > 接触阈值 1.05mm）；
    2. 正下方无轨孔（组间空档）-> 直落；
    3. 目标本身就是正下方外轨孔（CS/SA0）-> 直落，终点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
2026-10-19 feat(breadboard): 元件 7/8/9 全部接入 + net_check 连通性校验 + 图例自动换行
    面包板 Z 规划图 9/9 元件收尾：
    - 元件 7 模式按键：GPIO9 网经电源区扩展跳线从 l46 搬到列 29
    （原列 46 的 m/n/o46 被 MAX98357A 本体挡死，只剩 l46 一孔），
    按键跨中隔槽插 o29/p29，10k 上拉 n29←n27；位置三次重排
    （列 41-43 撞麦克风弧线走廊 -> 列 31 撞电源横档丝印 -> 列 27-29 定案）。
    - 元件 8 身份更正（用户决策）：不是电池分压电阻，而是 MP1584EN
    降压模块。系统供电 = 7.4V 电池 -> 5V -> ESP32 5V 脚 k52 + 5V 轨；
    电机 VM 直取 7.4V 不经降压。本体板外 x[70,92]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
2026-10-19 refactor: 状态文案统一走资源，清掉固件死代码与过期注释
    - DeviceStatus 的模式名/电量/Wi-Fi/故障文案改为读 strings.xml，
    不再和布局按钮各写一份中文；新增 battery_no_sample/battery_charging/wifi_value
    - DeviceApi 判空收口到 ipReady()、响应体读取收口到 readBody()
    - ai_dog_battery: 删掉只声明未使用的 was_valid（末尾还留了 (void) 掩盖告警）
    - ai_dog_diag: 删未使用的 kMagicU32 与没人调用的 Info()；
    Warn/Error 的 vsnprintf 收成 AppendFormatted + FormatLine；
    两处插入排序合并为 SortBySeq 模板
    - ai_dog_s3_board: Connected 的 ClearFault 收口进 HandleNetworkEvent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
    [ai_dog_battery.cc, ai_dog_diag.cc, ai_dog_diag.h, ai_dog_s3_board.cc, config.h]
2026-10-20 feat(pcb): v1 设计基线生成器 + 布局图/机读基线
    - 新增 tools/gen_pcb_design.py：BOM + 42 网/137 pin-net + 布局坐标单一事实源，
    内置布局校验（同层重叠/板边净距/安装孔 keepout/天线带），硬冲突非 0 不出图
    - 80x70mm 2 层板：顶层射频与信号、底层电源；现有模块平躺直焊；OLED/VL53 上壳排线
    - 电源：2x18650 7.4V -> MP1584EN 5V -> AMS1117 3V3；电机 VM 直取 7.4V
    - 新增 FS5080E 2S 充电（DC 5V 输入）与 GPIO8 电池分压监测
    注：docs/PCB设计方案-v1.html 与 docs/PCB网表-v1.csv 因安全策略暂不可被 git 索引，未纳入本提交
    [pcb-design-baseline-v1.json]
2026-10-20 feat(pcb): v2 改为开发板直插承载板（80x90 两层）
    - 开发板插 2x22P 排母可拔，USB 端朝南缘；3V3 取自板载 LDO，
    USB/CH343/复位/BOOT 全部免画，GPIO 与面包板 1:1、固件零改动
    - 电机维持 VM=7.4V 直供（改 5V 方案因峰值 3.67A > MP1584EN 3A 否决）
    - 充电复用开发板 USB 口 5V：新增 D1 SS34 防倒灌 + SW1 充电开关
    （不选充电位会出现电池经升压自充的 1.9A 空耗回路）
    - 板高 70->90：开发板纵向 57.15mm，TB6612 必须落在插座针排以南
    - v1 归档为 tools/gen_pcb_design_v1.py；生成器内置布局校验 0 硬冲突
    注：docs/PCB设计方案-v2.html 与 docs/PCB网表-v2.csv 因安全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
    [pcb-design-baseline-v2.json]
2026-10-20 docs(pcb): 预览图改 10px/mm 重渲（文档内改嵌 SVG 矢量，PNG 不再被拉伸）
    - 之前 PNG 按 4px/mm 只有 416px 宽，HTML 里 width:100% 拉到 ~1040px 导致模糊
    - HTML 内改为 <img src="...svg">（矢量，任意缩放清晰）；PNG 仅作独立位图附件
2026-10-20 feat(pcb): 移除模式按键，释放 GPIO9
    - 删 K3 与 R6 上拉：网表 108 pin-net / 36 网，自研 BOM 23->21 项
    - 模式切换改为仅 App POST /api/mode，断网时无本地切换（风险表 11/12）
    - 固件 config.h 的 GPIO9 按键定义不动，待确认后单独清理
    - 空闲 GPIO 7 个：9/3/17/18/38/39/40/45
    [pcb-design-baseline-v2.json]
2026-10-20 fix(firmware): 删除零引用的 MODE_BUTTON_GPIO，修构建脚本第 7 坑
    - config.h: MODE_BUTTON_GPIO(GPIO9) 全仓零引用（模式切换本就只走 POST /api/mode），
    随模式按键取消一并删除，GPIO9 释放给传感器
    - build-ai-dog.ps1: Invoke-Ninja 未翻转 $ErrorActionPreference，CMake 重配置期间
    ninja 往 stderr 吐 Kconfig NOTE 会被当 NativeCommandError 中断（假失败）；
    按 Invoke-Idf 的既有套路加 Continue + 退出码判定
    - 验证：.\build-ai-dog.ps1 -Action build 通过，产物 build/xiaozhi.bin 0x281A40 (36% free)
    [config.h]
2026-10-20 feat(breadboard): 撤销元件 7 模式按键，GPIO9 释放（与 PCB v2.1 同步）
    - 删 BUTTON 组件（按键 + 10k 上拉）与 3 根造网跳线（GPIO9/3V3/GND 扩展）+ 1 根轨组桥
    - 电源区 16 根网线 -> 12 根（6 馈线 + 6 桥）；o29/p29/n29/n27/l29/l46/n28 七孔恢复空闲
    - net_check: 改为按 w["net"] 断言（不再依赖 list 索引），连通性 0 处断网/短接
    - 图例/标题/注释同步；预览图按 10px/mm 重渲
    注：wire_check 退出码 1 为 HEAD 既有状态（inmp441 6 + max98357a 9 根压本体/本体跳线类，
    两版问题集合逐条比对完全一致），本次改动未新增任何净空/假短路问题
    [gen_breadboard_z.py, net_check.py]
2026-10-20 feat(pcb): v2.2 焊盘级布局 + 针号全映射 + 高度剖面/底层视图
    - 布局图升级到焊盘级：2.54 栅格焊盘、1 脚方标、针名标注（开发板两排 22 针 + 各模块排针 + 连接器）
    - 网表 PinNo 108/108 全部映射：开发板 J1-/J3- 列号（与面包板行列一致）、模块按丝印、无源件 1/2
    - 新增高度剖面（侧视 1:1）：最紧为开发板+MP1584EN 叠放区 23.6mm，底盘该区净高需 >=26mm
    - 新增底层视图（镜像）：底层器件实线 + 顶层贯穿孔虚线，装配对位用
    - 标题/尺寸标注改动态（原写死 80x70）
    [pcb-design-baseline-v2.json]
2026-10-20 feat(pcb): 导出可导入 EDA 的 DXF 板框（v2.3）
    - tools/gen_pcb_design.py 增加 write_dxf：R3 圆角矩形 + 4x d3.4 安装孔，R12 ASCII/mm
    - DXF 的 y 轴翻转（y=H-y，圆弧起止角取补），导入嘉立创EDA后方向与布局图一致
    - 校验：4 LINE + 4 ARC + 4 CIRCLE，孔位 (6,6)(74,6)(6,84)(74,84) 翻转后正确
    [pcb-outline-v2.dxf]
2026-10-20 feat(pcb): 生成 EDA 原理图建图顺序表（36 网 / 108 连接）
    - 从网表数据自动生成 docs/EDA-schematic-checklist-v1.html：元件清单（EDA 搜什么/封装/放法）
    + 按阶段排序的连线表（电源→地→总线→控制）+ 自检点 + 8 条易错点
    - 表内勾选框可直接在预览面板打勾；GND 成员数等统计随网表动态生成
    - 模块类器件（TB6612/MP1584EN/MAX98357A/INMP441）给出"用 2.54 排母座 + 自定义针名"的建符号做法
    - 踩坑：HTML 模板里的 CSS 百分号会撞 Python %-格式化（需转义为 %%）；中文名 HTML 被安全策略拦，改 ASCII 名
2026-10-20 feat(sch): 生成网络标签式原理图（KiCad 7，108 条连接全覆盖）
    - tools/gen_kicad_sch.py：从 gen_pcb_design 的 NETS 生成 .kicad_sch（每针短线+全局标签，
    连接靠网名而非几何，天然不漏）+ 同版式的 SVG 预览
    - 六栏分区（电源/主控/音频/电机/传感器/分压指示），A2 图幅；符号=矩形+左侧引脚，针号 1..N
    - 独立校验（S 表达式回读）：28 实例 / 108 标签 / 108 导线；0 悬空、108/108 一端在引脚、
    108/108 一端在标签、0 引脚无引线；36 网名（GND 17 / 3V3 8）与网表一致
    - 修：J3 电池座漏在栏外导致 106/108，并加"网表每个位号必须被放置"的硬校验
    [ai-dog-v1.kicad_sch]
2026-10-20 refactor: 删零调用接口与面包板生成器的重复/残留定义
    固件（ai-dog-s3）：
    - 删 ControlServer::GetMode()：全 main/ 零调用，模式只由 /api/status 与
    SetMode 暴露，不需要单独 getter。
    - 删 MotorDriver::GetSpeeds()：零调用，且 last_left_/last_right_ 只服务于
    SetSpeeds 的"状态没变就跳过"去抖，不是对外状态。
    - 删 DeviceLog::Dump() 及其 4KB dump_buffer_：零调用的内存环快照。内存环
    现在只是"待落盘暂存"，看历史一律走启动时的 DumpFlash，不再开第二个读取口子。
    - diag.h 同步改写内存环的注释，避免后人又去补一个读取接口。
    tools：
    - gen_breadboard_z.py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
2026-10-21 refactor: 收口重复逻辑与过期注释（Android/固件/构建脚本）
    - DeviceApi.startStatusPush 补 ipReady() 守卫：拼 ws:// 地址前 baseUrl 为
    null 会直接 NPE，和 post()/move() 的判空口径保持一致。
    - MainActivity.stopMove 的注释写着"不弹窗"、代码却在弹，改成与实现一致。
    - 电池档位回调里 Unknown 分支重复设置 SetBatteryLevelText("unknown")
    （回调第一行已经按档位设过），删掉重复赋值；default 保留是因为
    -Werror=switch 会因漏枚举分支直接编译失败。
    - 电压跳变判定原来是两次单向比较，收成 std::fabs 一处，阈值提为常量
    kReportDeltaV。
    - conf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
